minglang-create/Glove_DAQ_project/STM32/G474CBT6/myDoc/frame/SPI事务包格式.png

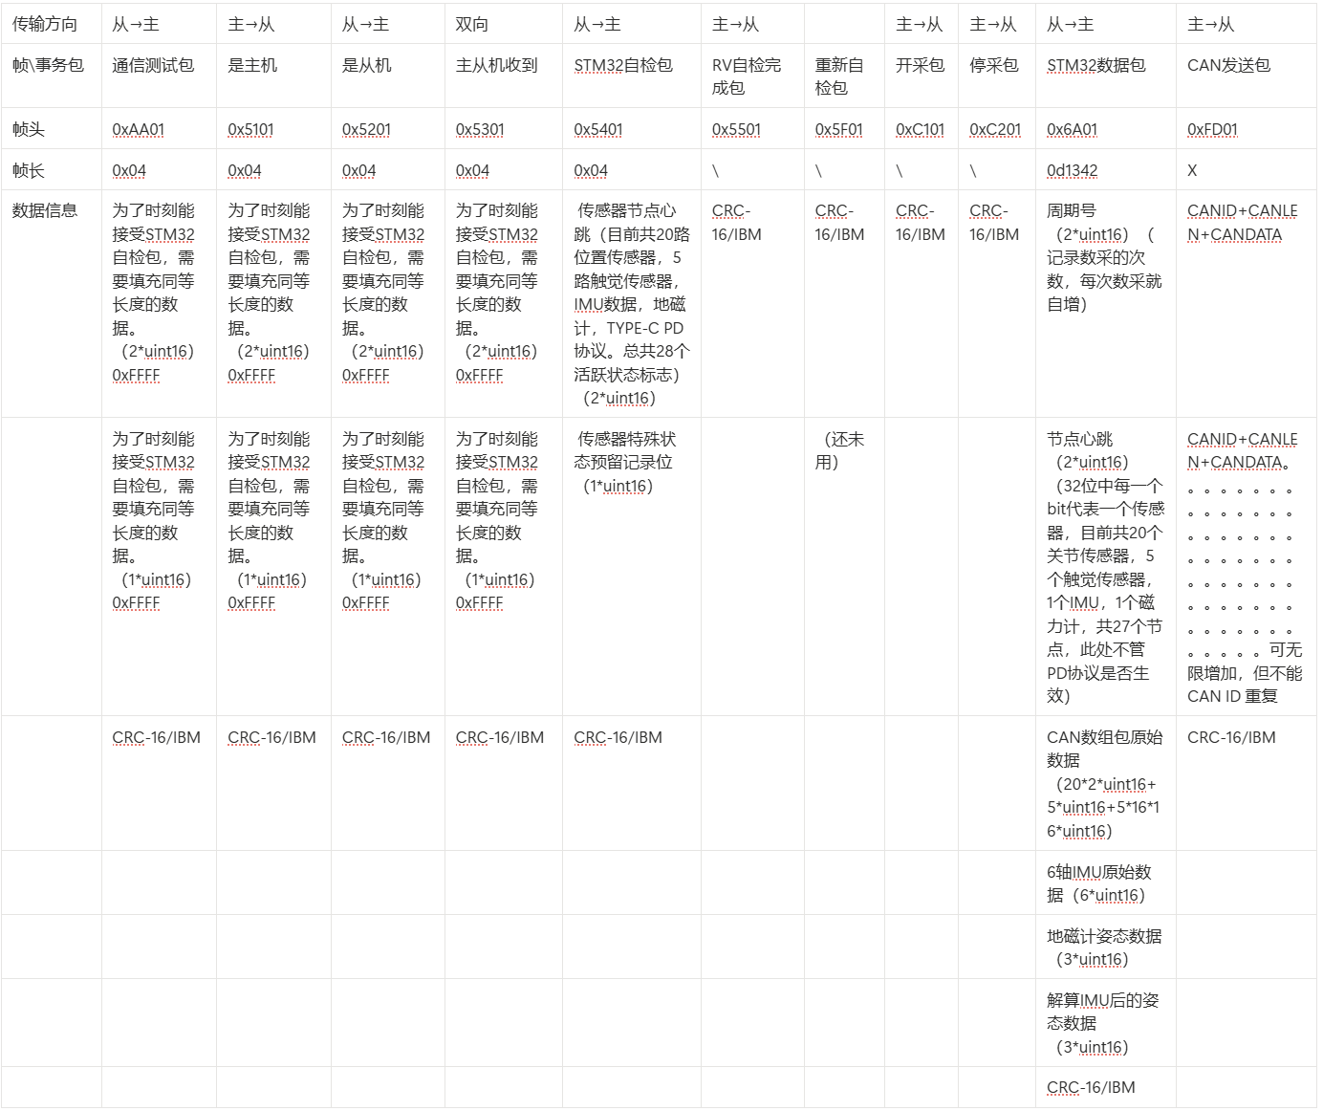
STM32/G474CBT6/myDoc/frame/SPI事务包格式.png
