minglang-create/Glove_DAQ_project/STM32/G474CBT6/myDoc/PCB/BOOT_POWER.png

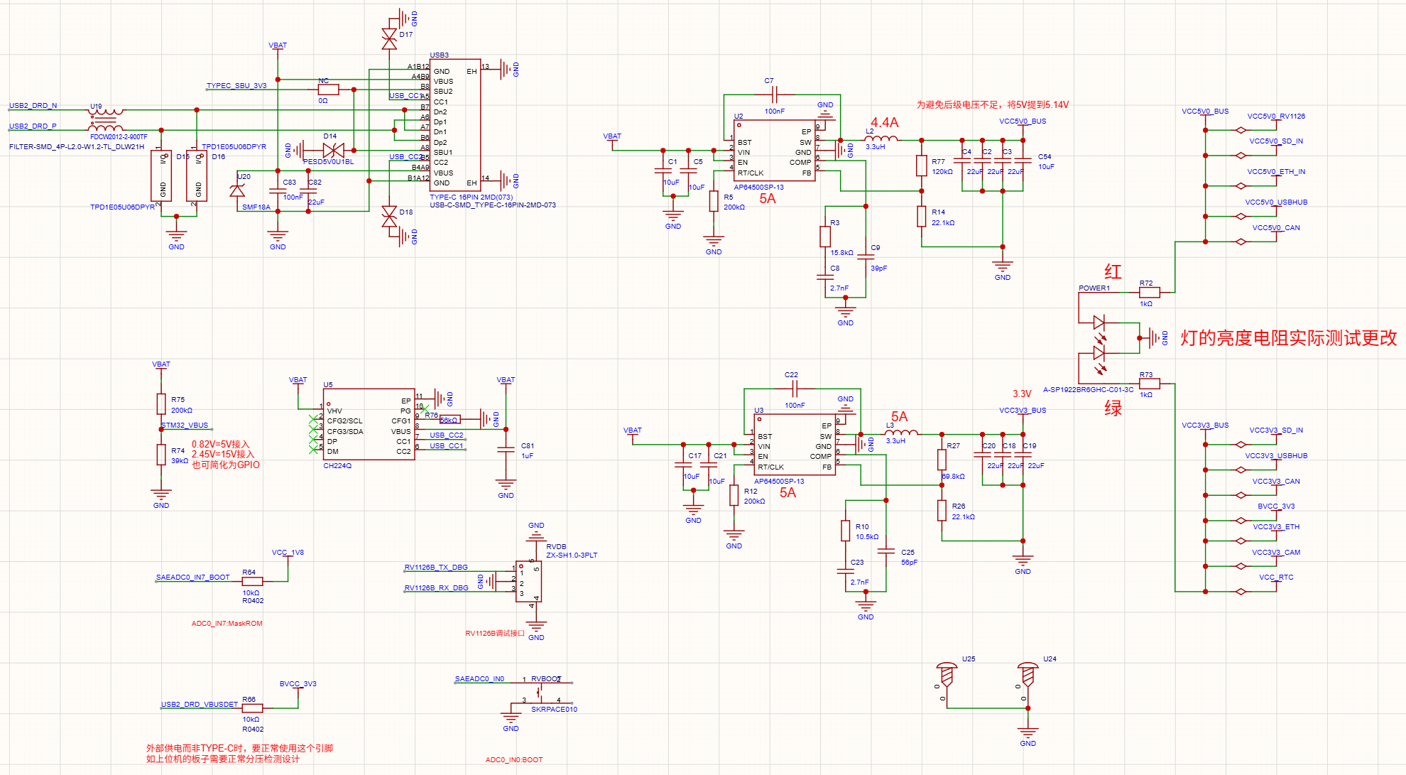
STM32/G474CBT6/myDoc/PCB/BOOT_POWER.png
