minglang-create/Glove_DAQ_project/STM32/G474CBT6/myDoc/PCB/ETH.png

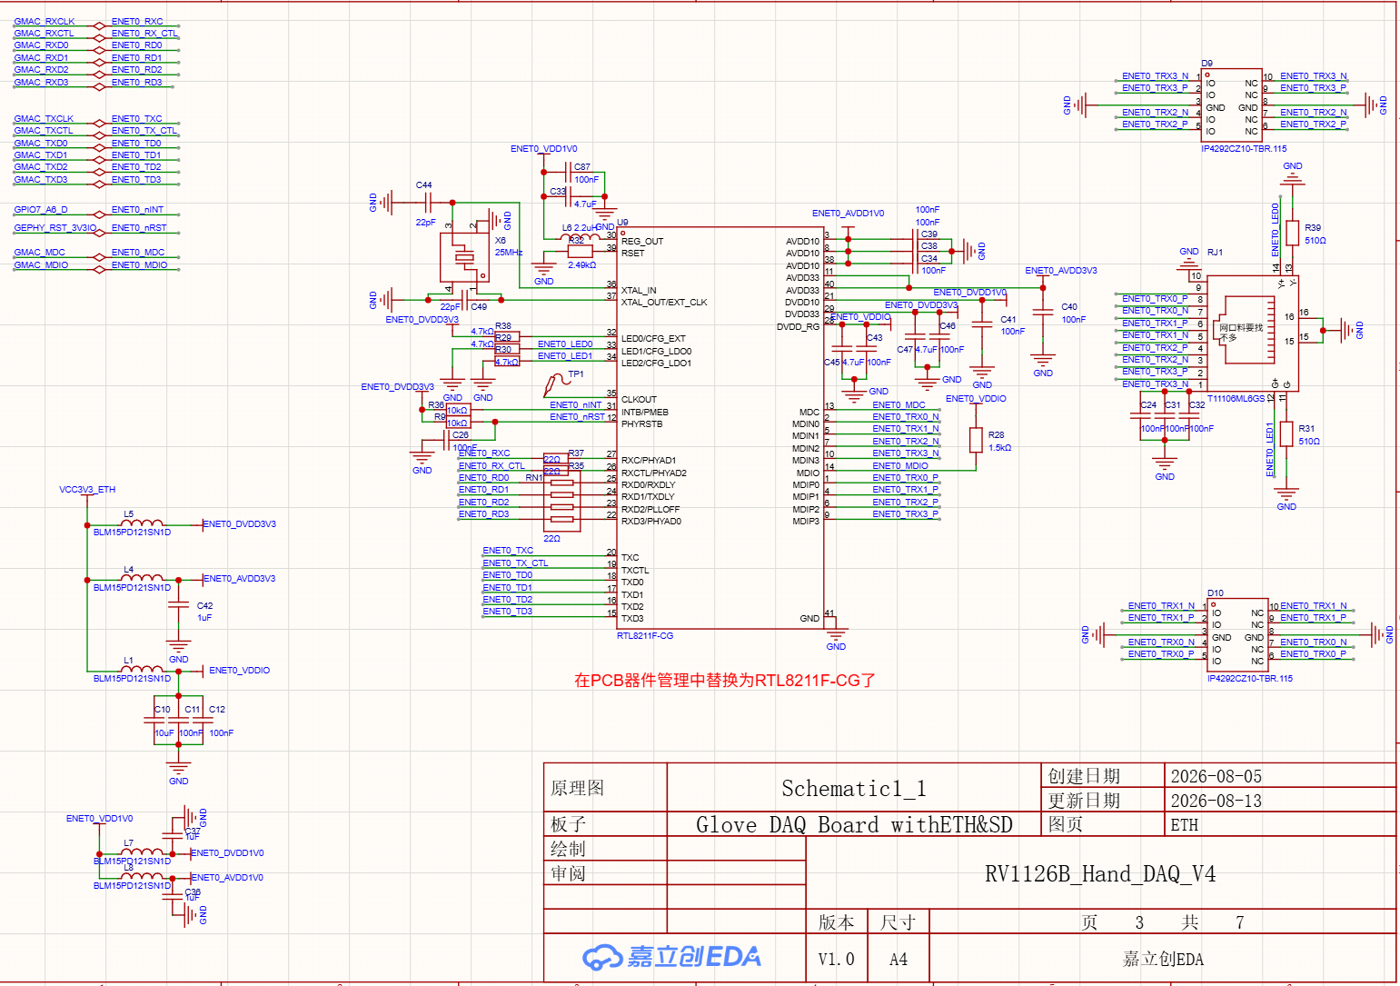
STM32/G474CBT6/myDoc/PCB/ETH.png
