minglang-create/Glove_DAQ_project/STM32/G474CBT6/myDoc/PCB/INTERFACE.png

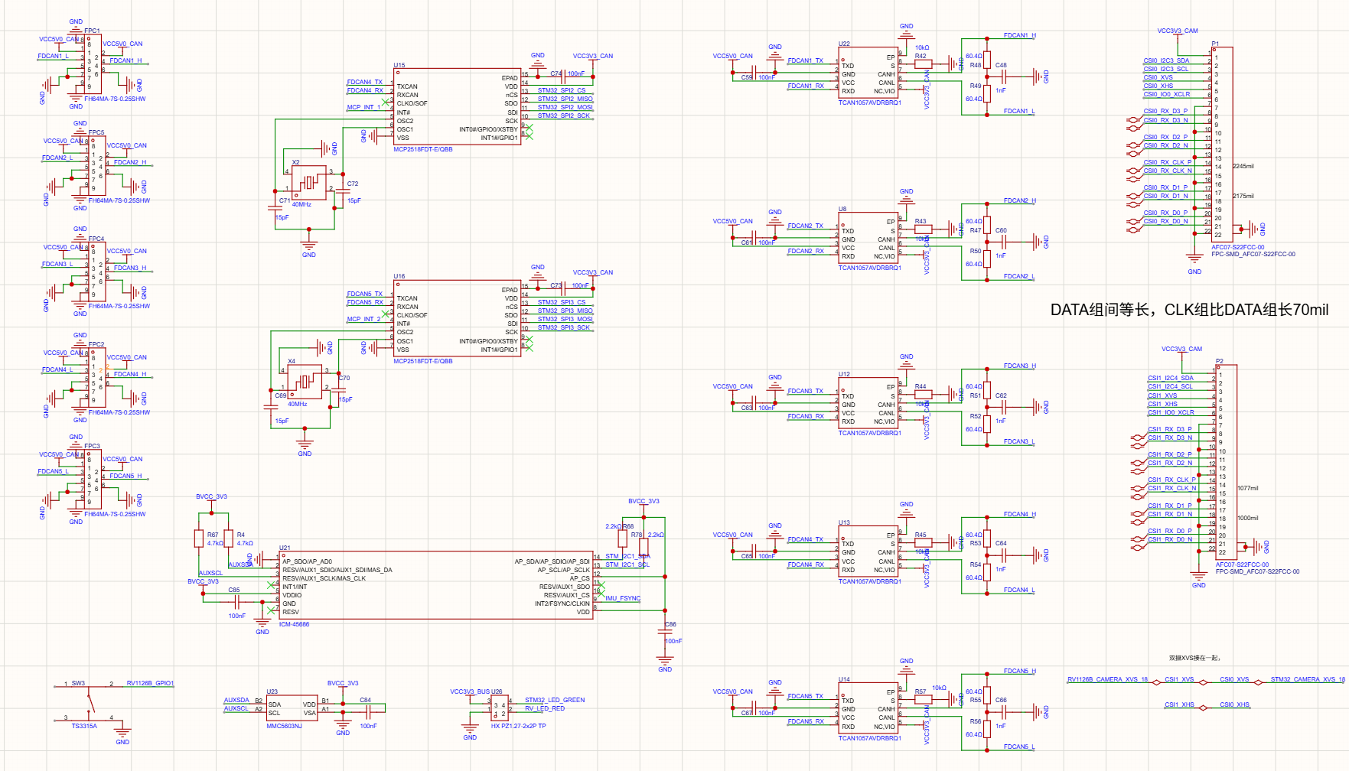
STM32/G474CBT6/myDoc/PCB/INTERFACE.png
