minglang-create/Glove_DAQ_project/STM32/G474CBT6/myDoc/PCB/MCU.png

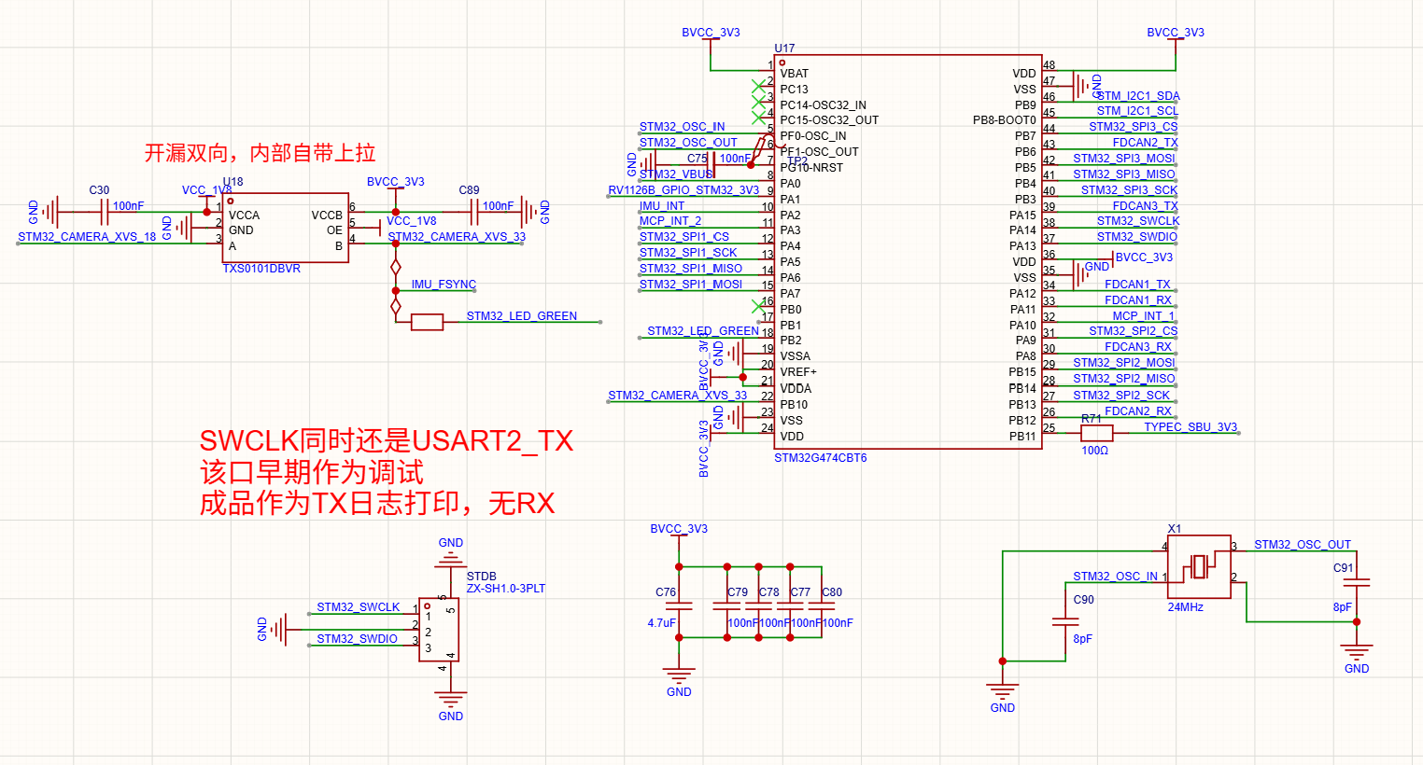
STM32/G474CBT6/myDoc/PCB/MCU.png
