minglang-create/Glove_DAQ_project/STM32/G474CBT6/myDoc/render/bot-5.png

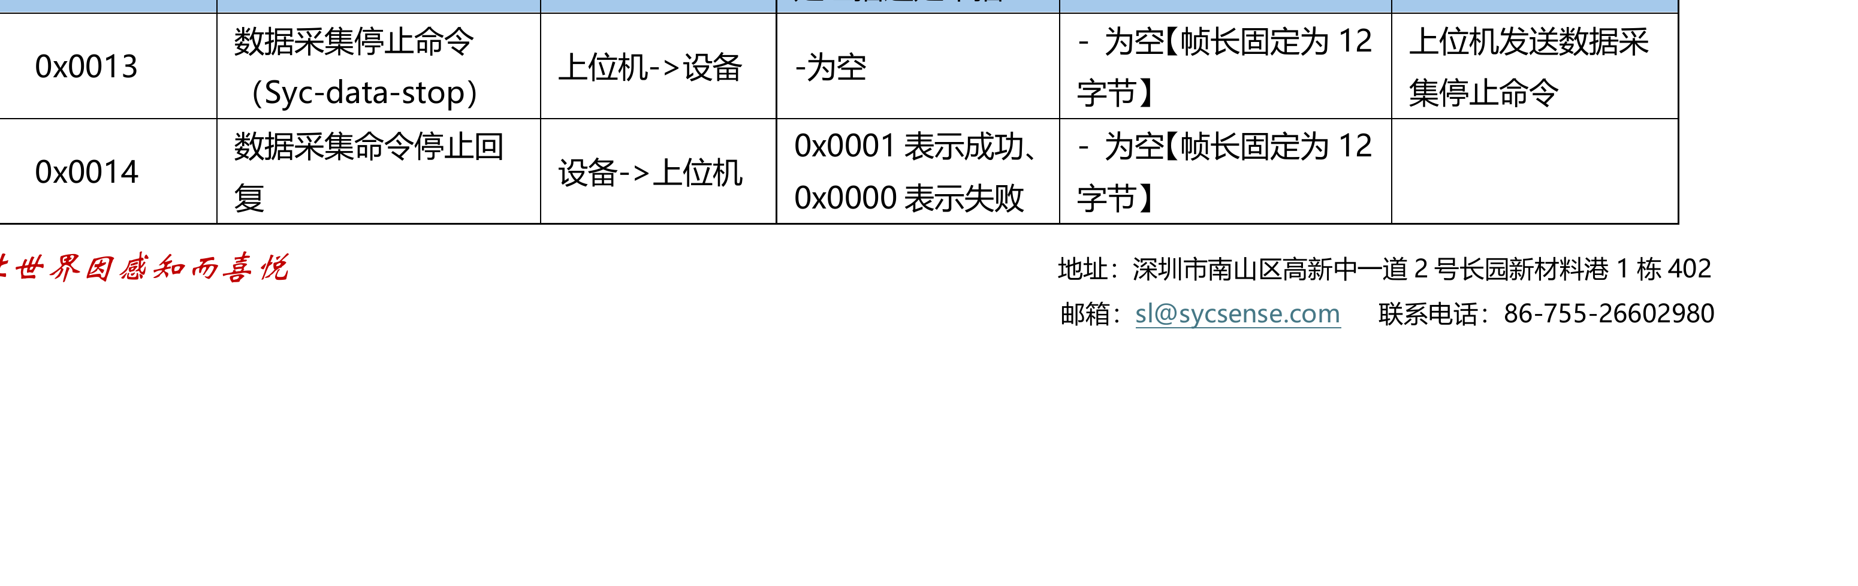
STM32/G474CBT6/myDoc/render/bot-5.png
