minglang-create/Glove_DAQ_project/STM32/G474CBT6/myDoc/render/cell12-5.png

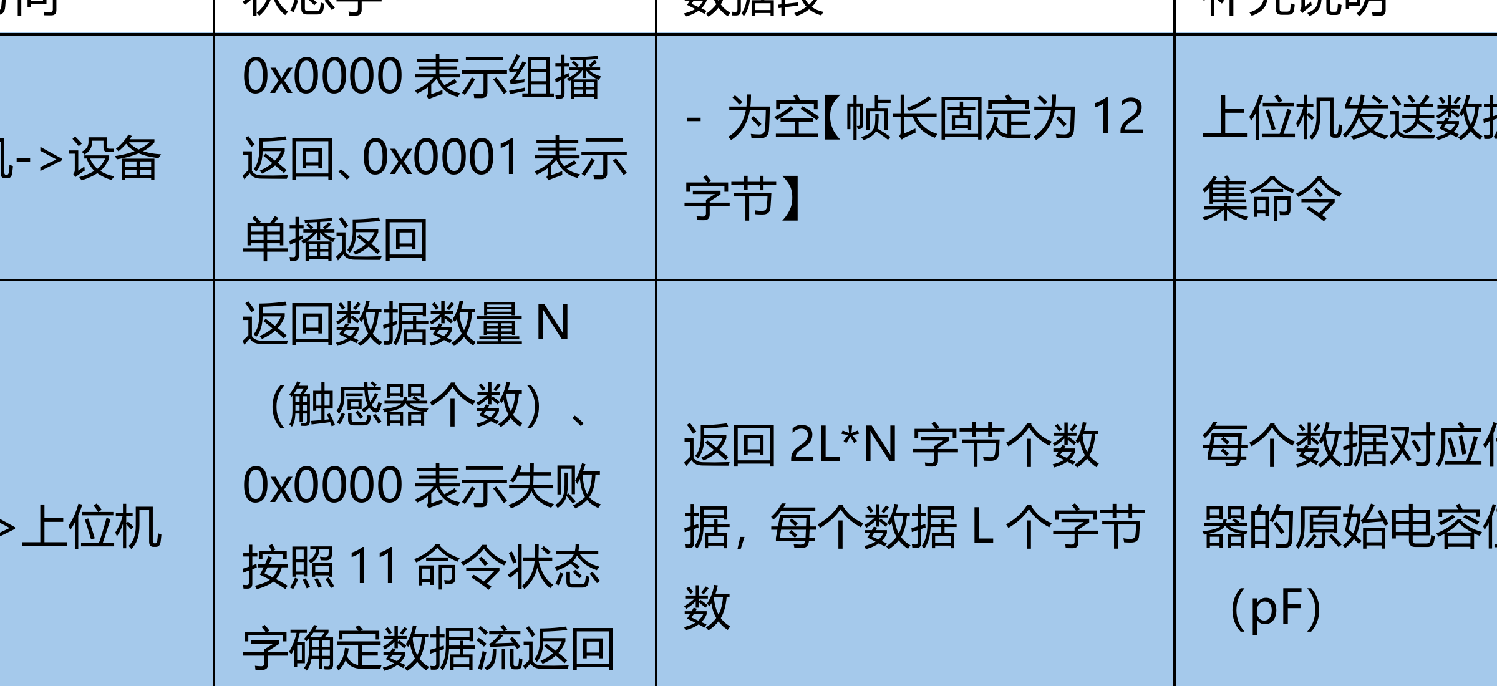
STM32/G474CBT6/myDoc/render/cell12-5.png
