minglang-create/Glove_DAQ_project/STM32/G474CBT6/myDoc/render/p-2.png

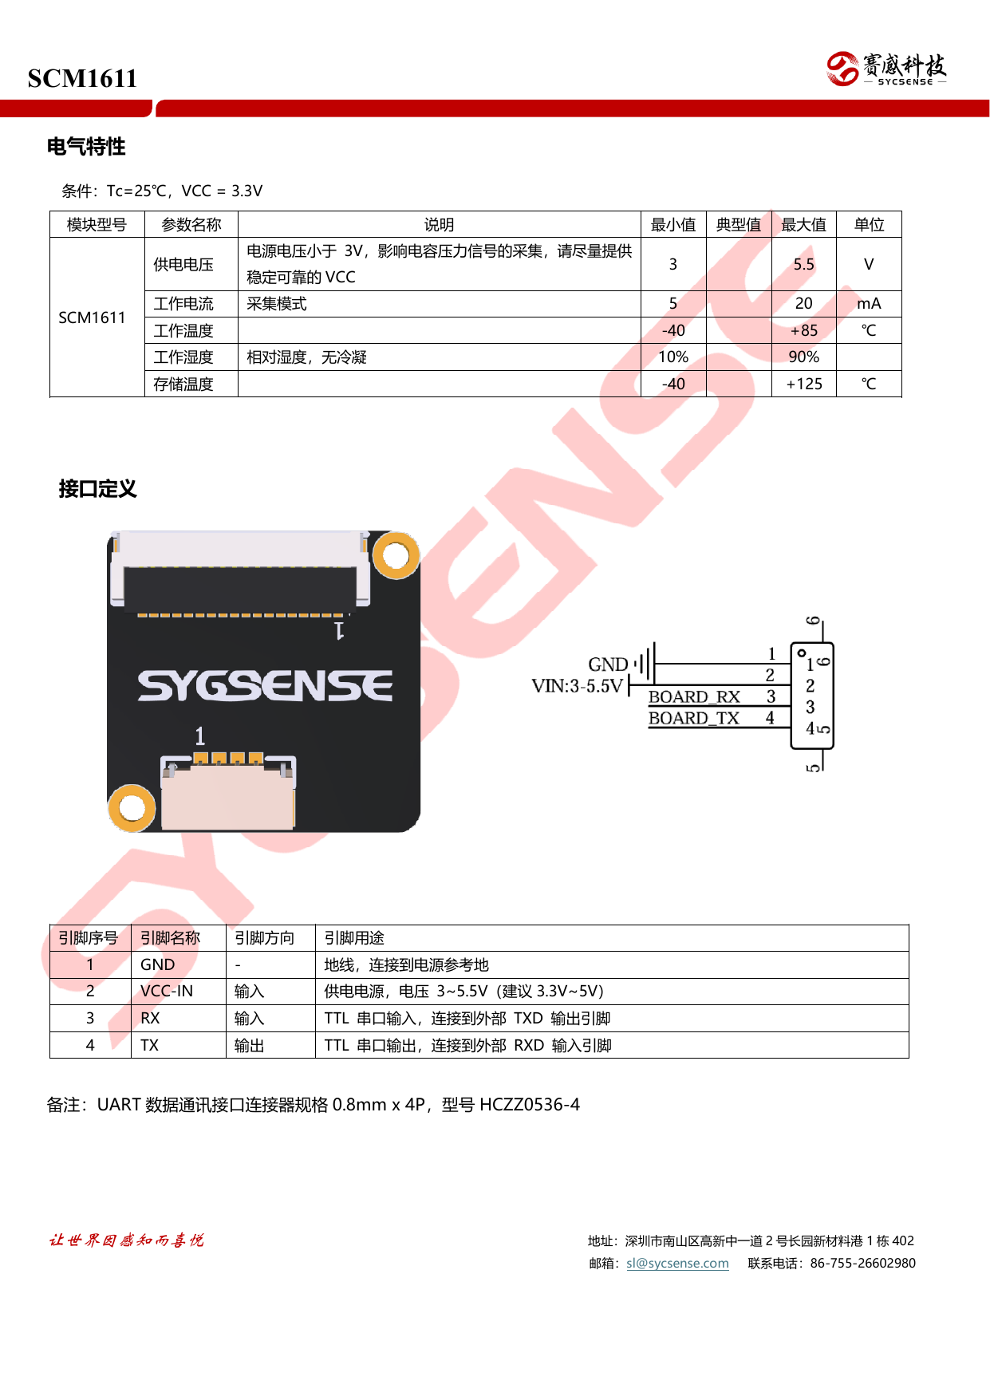
STM32/G474CBT6/myDoc/render/p-2.png
