minglang-create/Glove_DAQ_project/STM32/G474CBT6/myDoc/render/pwm-09.png

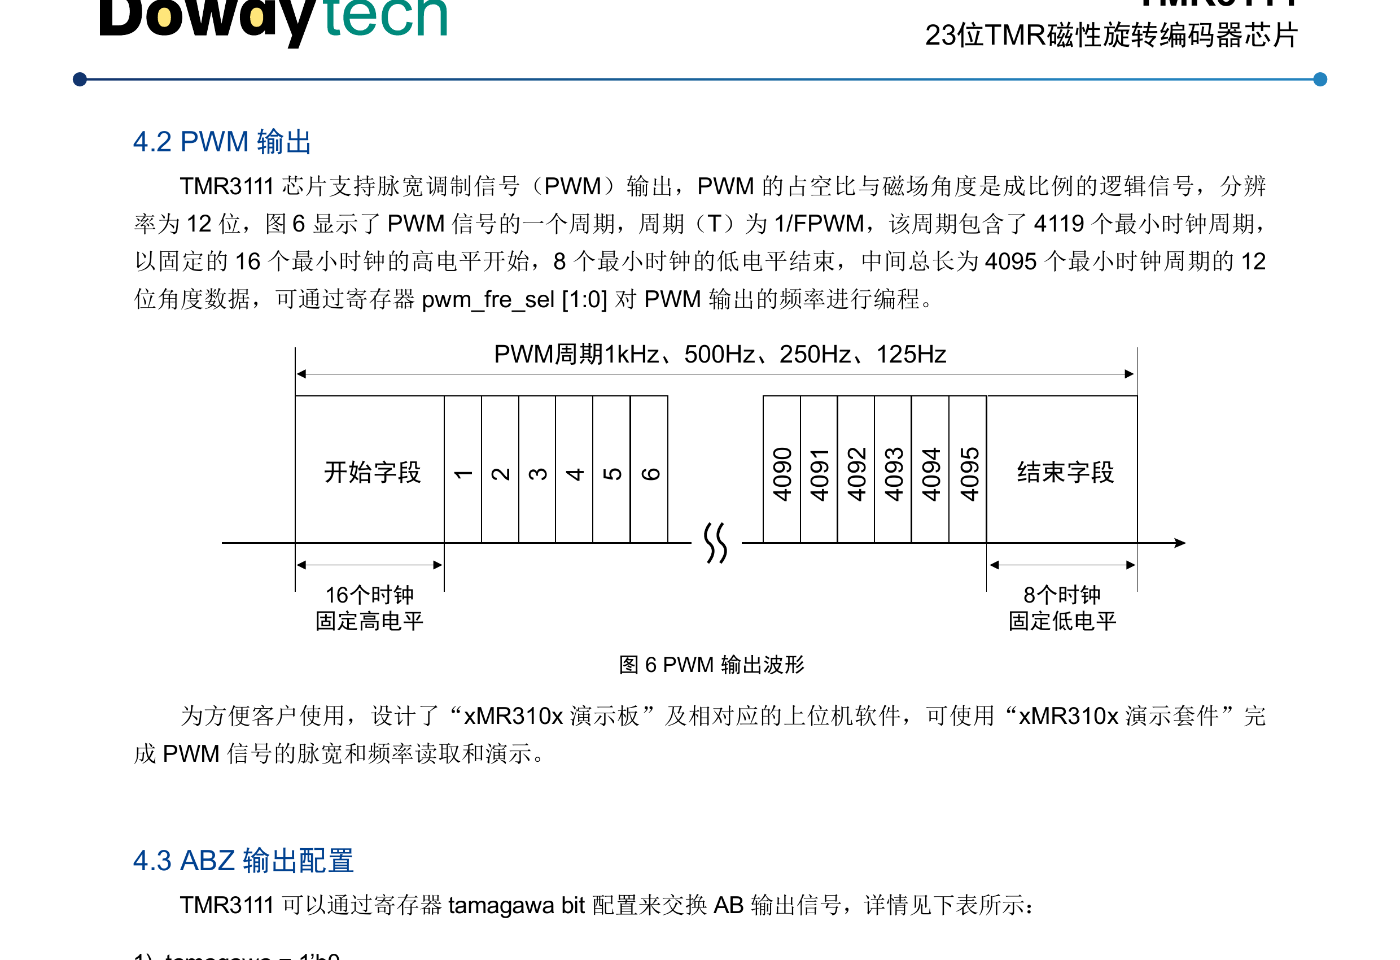
STM32/G474CBT6/myDoc/render/pwm-09.png
