minglang-create/Glove_DAQ_project/STM32/G474CBT6/myDoc/render/tmr-05.png

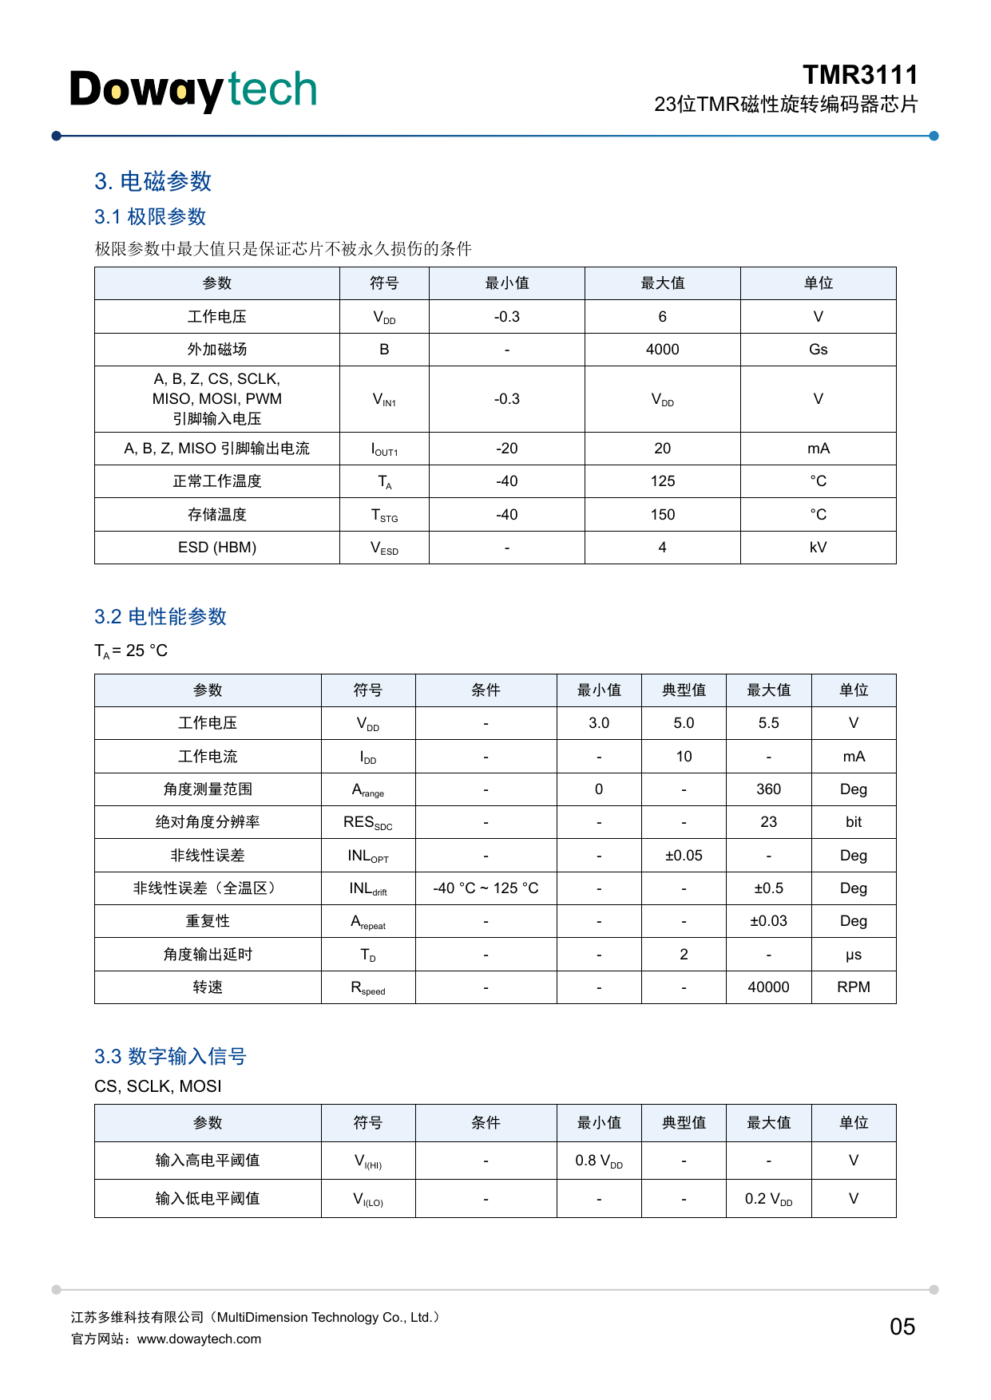
STM32/G474CBT6/myDoc/render/tmr-05.png
