minglang-create/Glove_DAQ_project/STM32/G474CBT6/myDoc/MYZR-RV1126B-LB221-REVA-OPEN.pdf

5

4

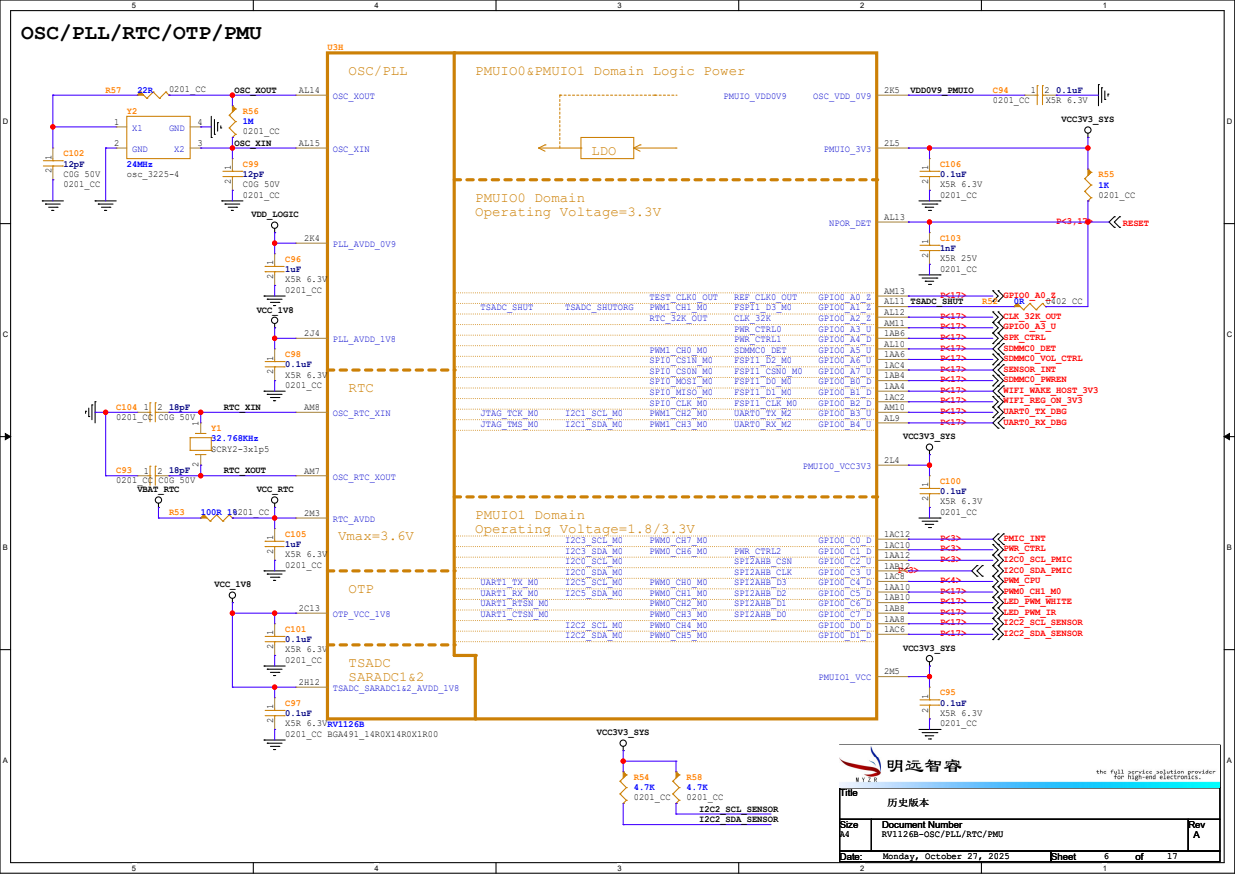
[picture p39: page 1]

OSC/PLL/RTC/OTP/PMU

# DDR Controller

# LPDDR4/4x AC

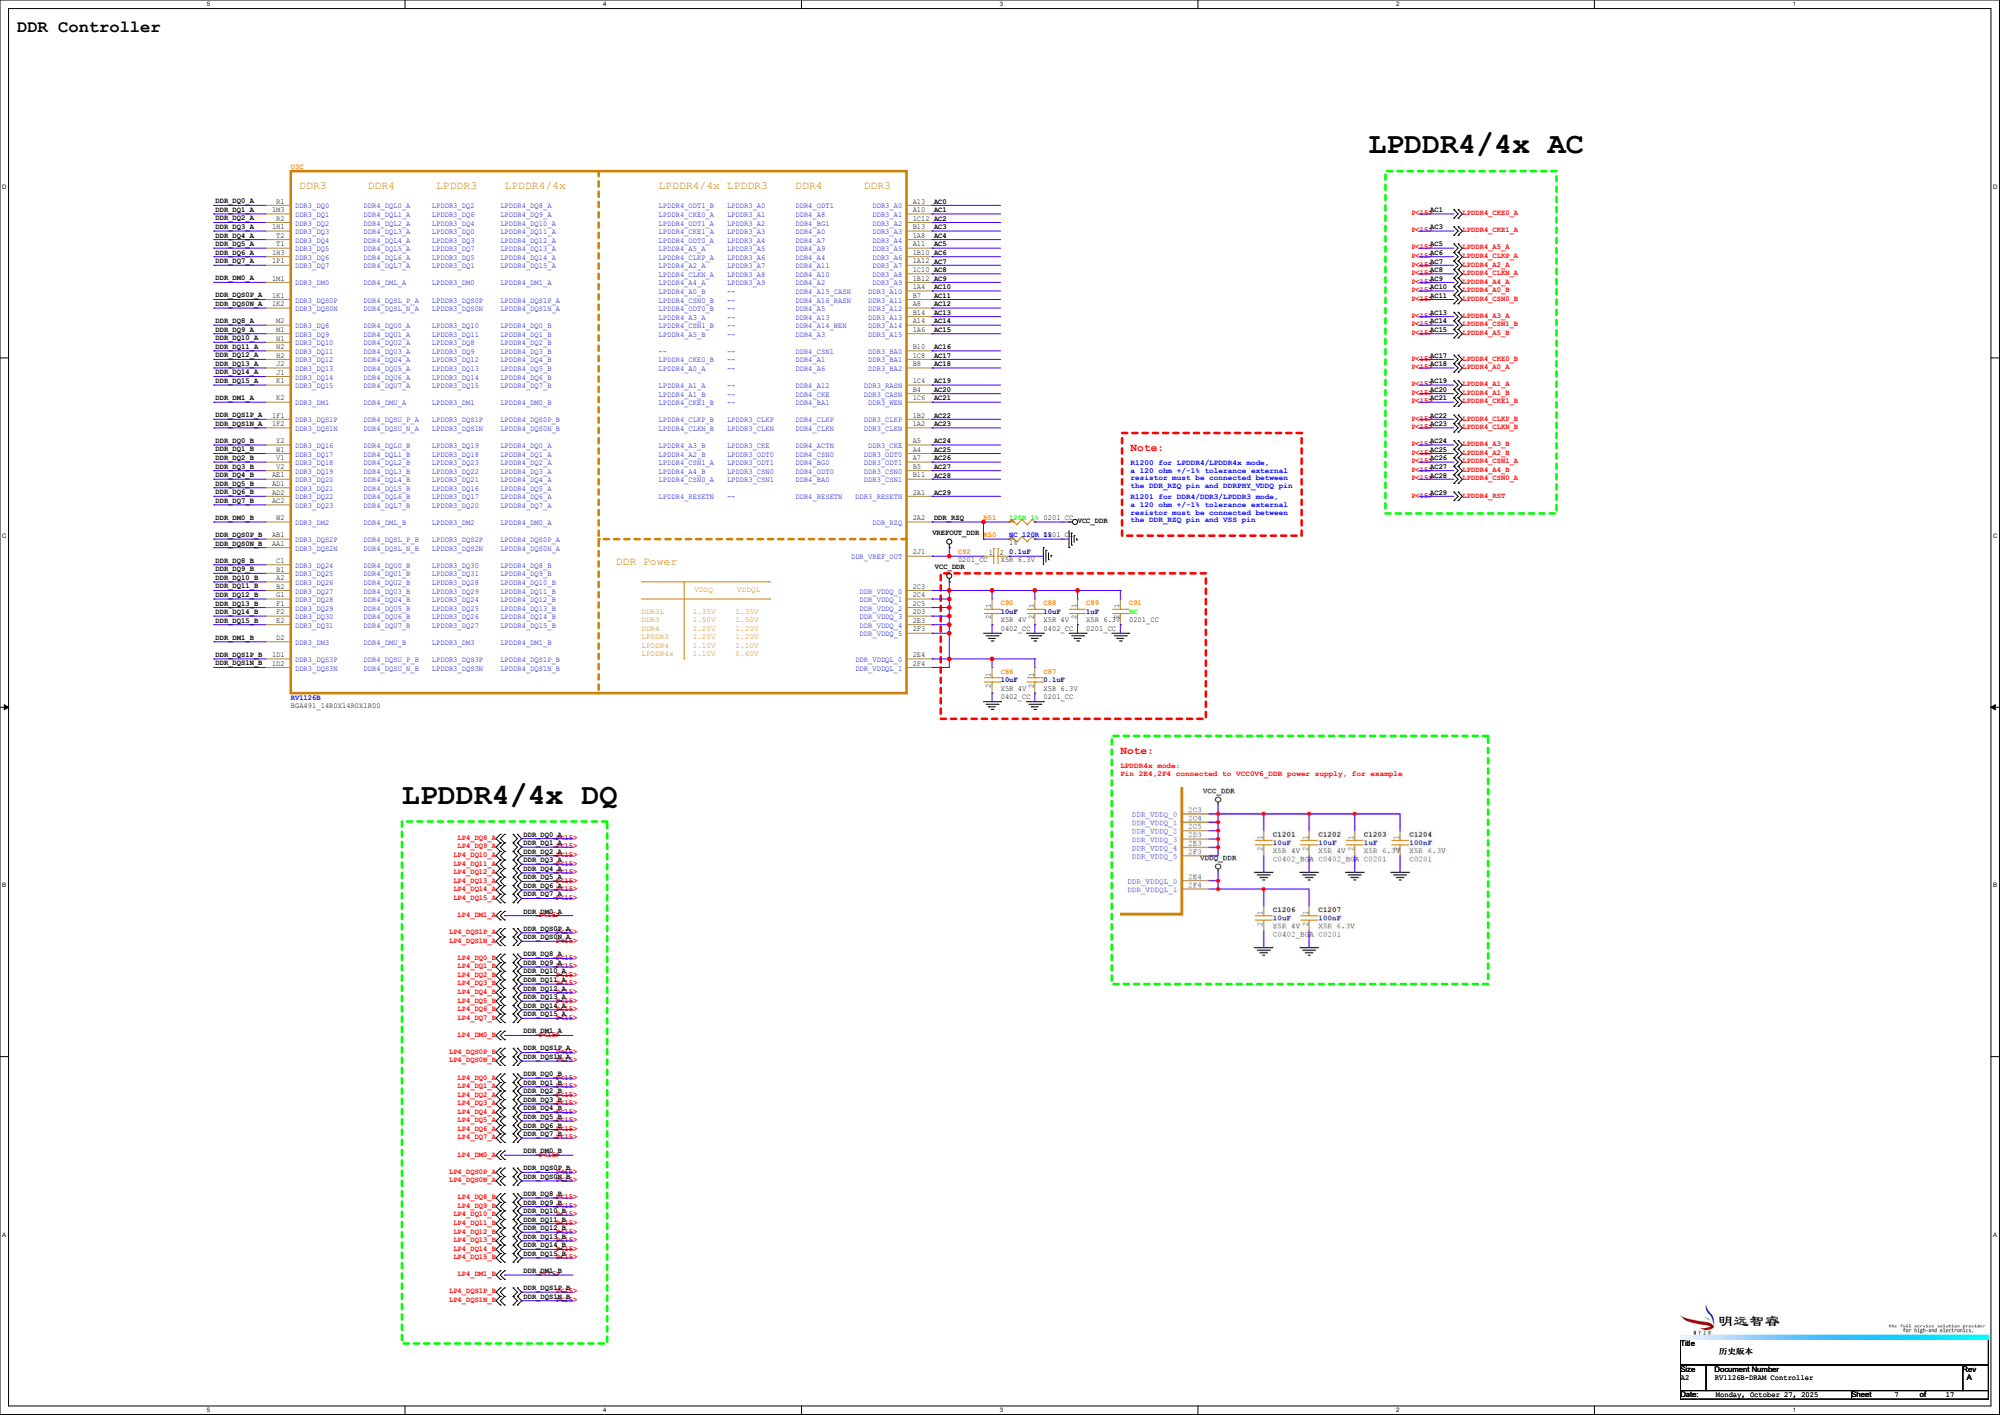
[picture p40: page 2]

R1200 for LPDDR4/LPDDR4x mode,
a 120 ohm +/-1% tolerance external
resistor must be connected between
the DDR_RZQ pin and DDRPHY_VDDQ pin
R1201 for DDR4/DDR3/LPDDR3 mode,
the DDR_RZQ pin and VSS pin

LPDDR4x mode:
Pin 2E4,2F4 connected to VCC0V6_DDR power supply, for example

# EMMC/FSPI

## VCCIO1 Domain

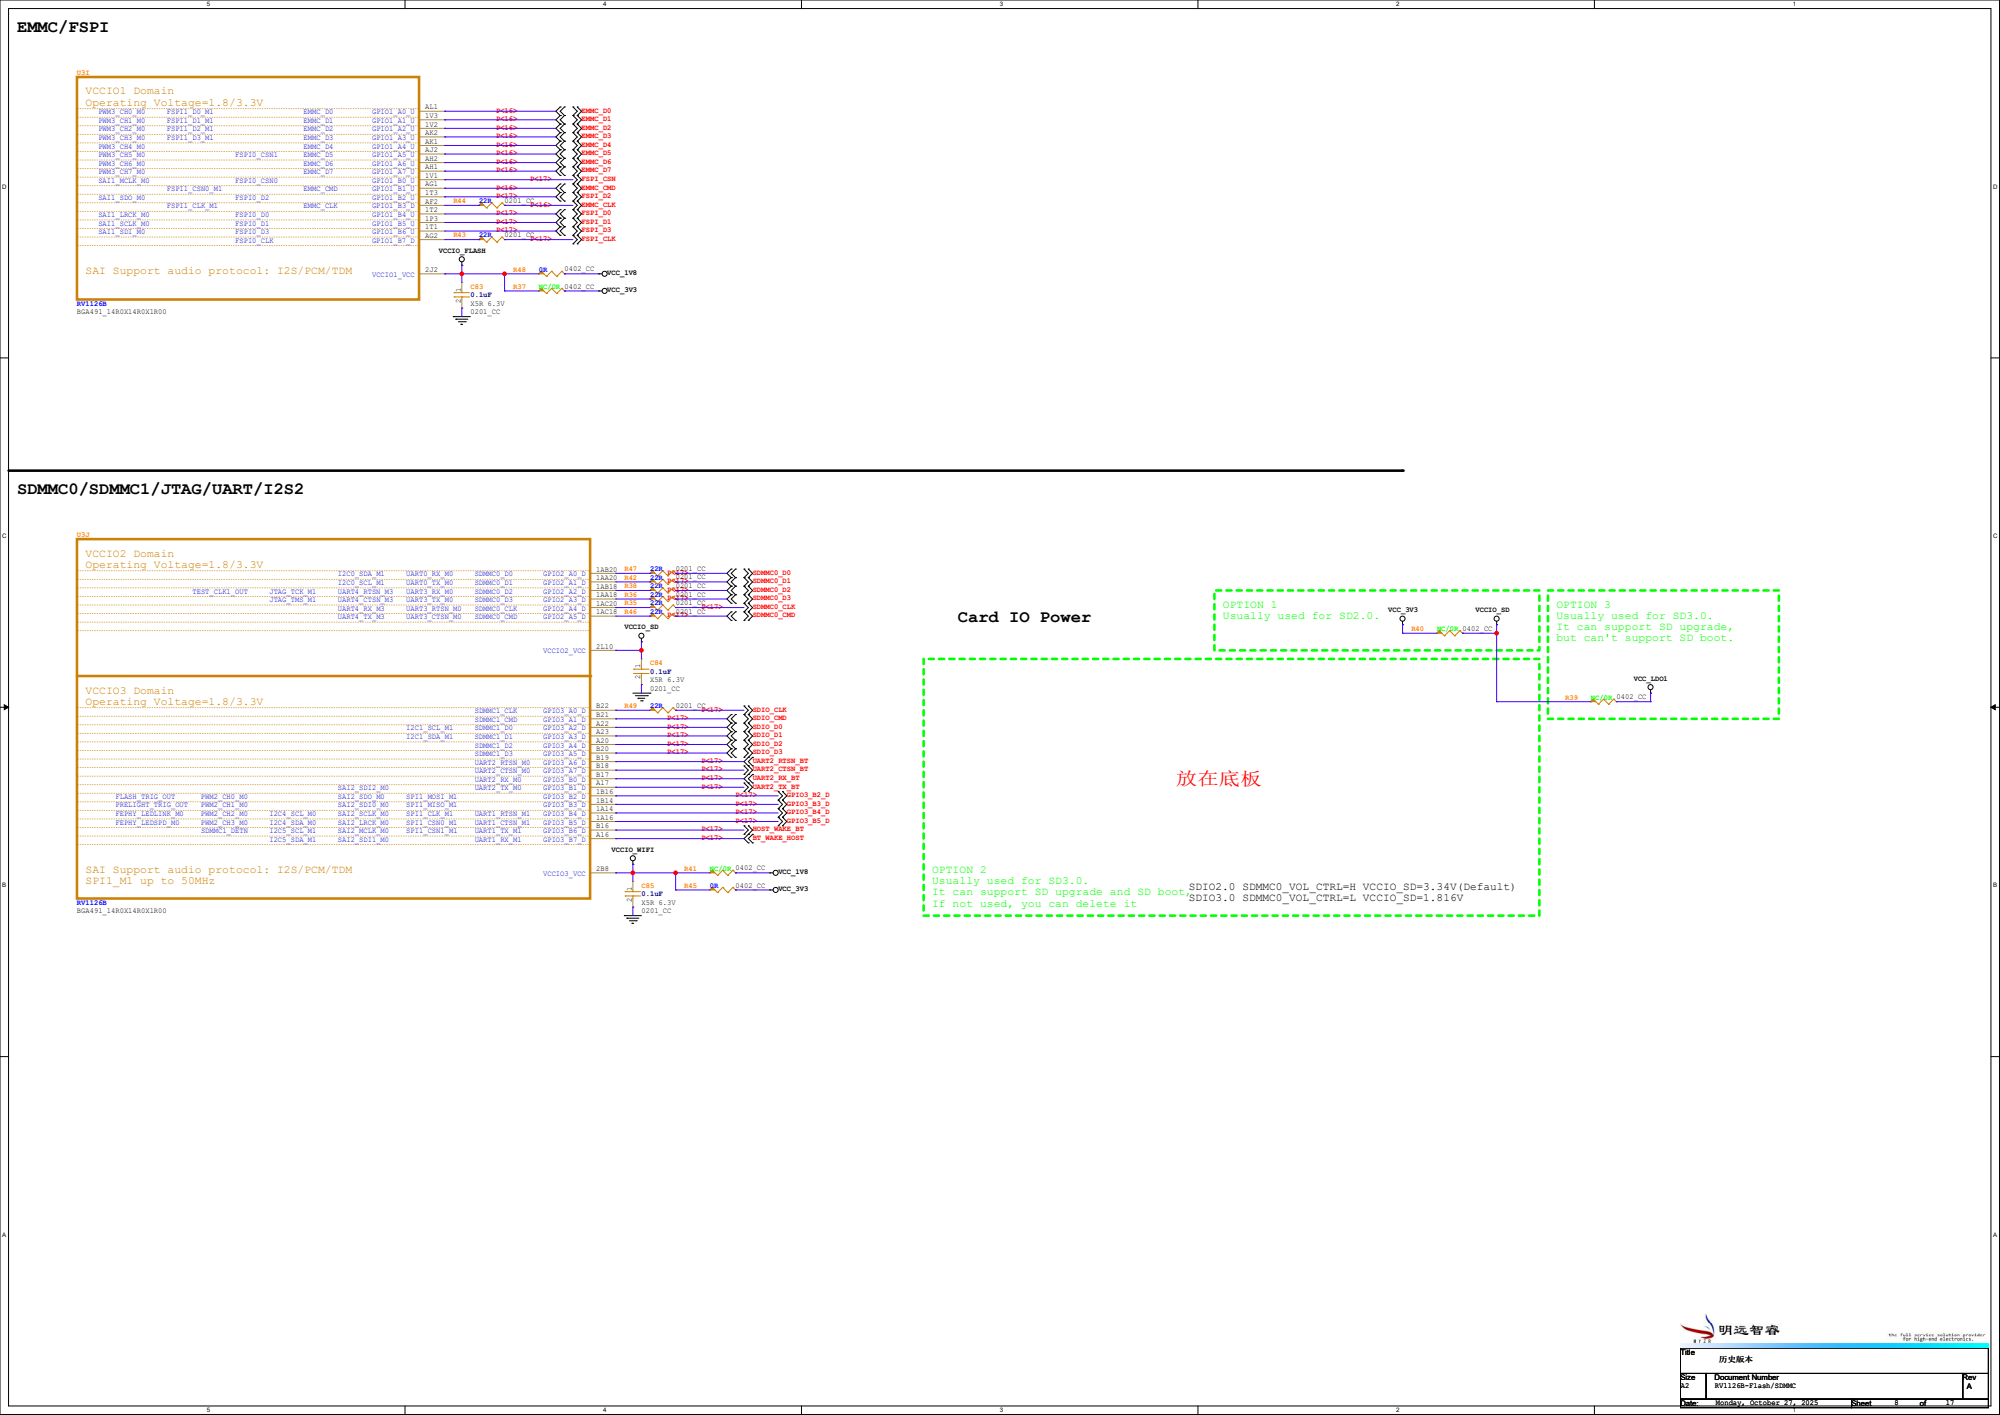
[picture p41: page 3]

SAI Support audio protocol: I2S/PCM/TDM

Usually used for SD3.0.
It can support SD upgrade,
but can't support SD boot.

SPI1_M1 up to 50MHz

OPTION 2
It can support SD upgrade and SD boot,
If not used, you can delete it

D D

# USB Controller

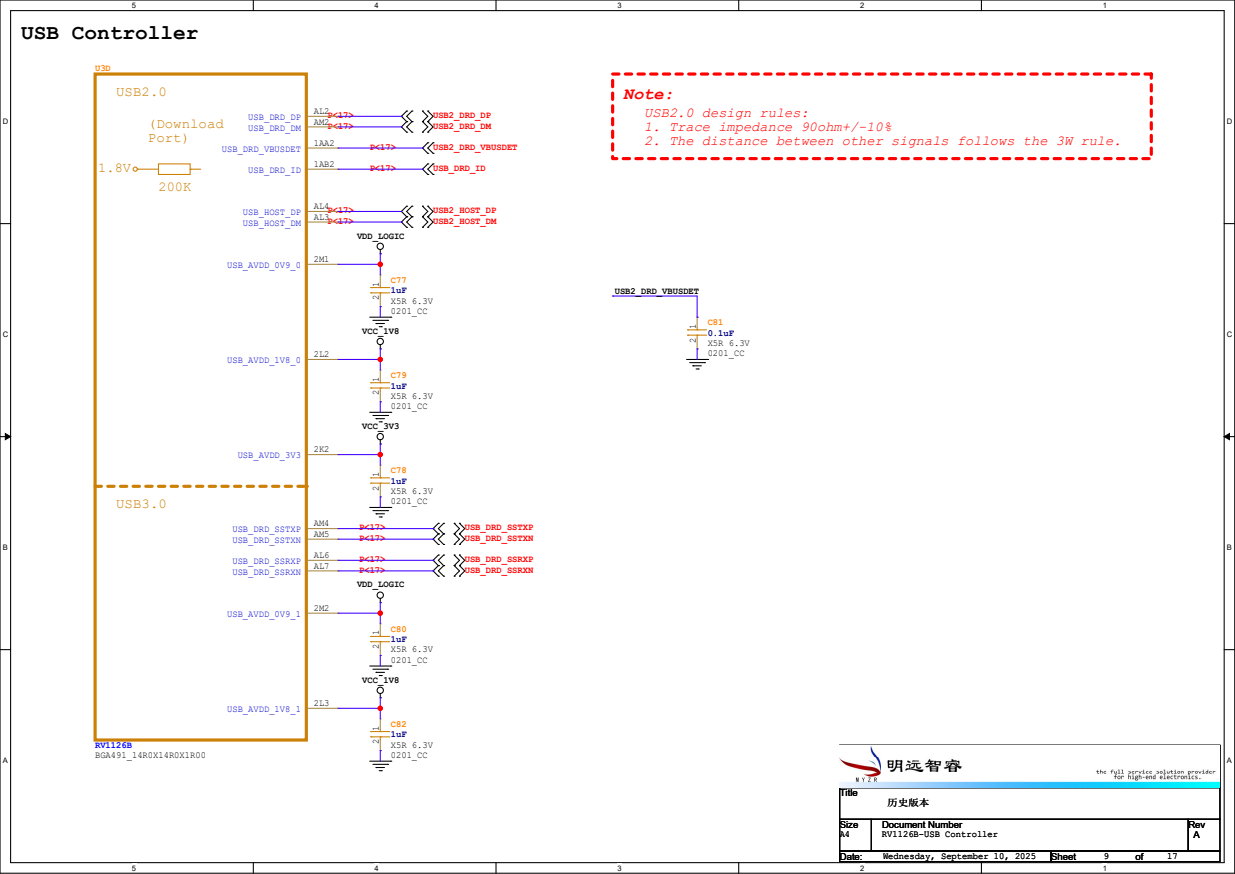
[picture p42: page 4]
VDD_LOGIC; VCC_1V8; VCC_3V3; USB2_DRD_DP; USB2_DRD_DM; USB2_DRD_VBUSDET; USB2_HOST_DP; USB2_HOST_DM; USB_DRD_SSTXP; USB_DRD_SSTXN; USB_DRD_SSRXP; USB_DRD_SSRXN; USB_DRD_ID; Title; RV1126B-USB Controller; Wednesday, September 10, 2025; USB3.0; USB2.0; (Download Port); RV1126B BGA491_14R0X14R0X1R00; USB_DRD_VBUSDET 1AA2; USB_AVDD_1V8_0 2L2; USB_AVDD_3V3 2K2; USB_HOST_DM AL3 USB_HOST_DP AL4; USB_DRD_DM AM2 USB_DRD_DP AL2; USB_DRD_ID 1AB2; USB_AVDD_0V9_0 2M1; USB_AVDD_0V9_1 2M2; USB_AVDD_1V8_1 2L3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

Note:
USB2.0 design rules:
1. Trace impedance 90ohm+/-10%
2. The distance between other signals follows the 3W rule.

D D

# SARADC0

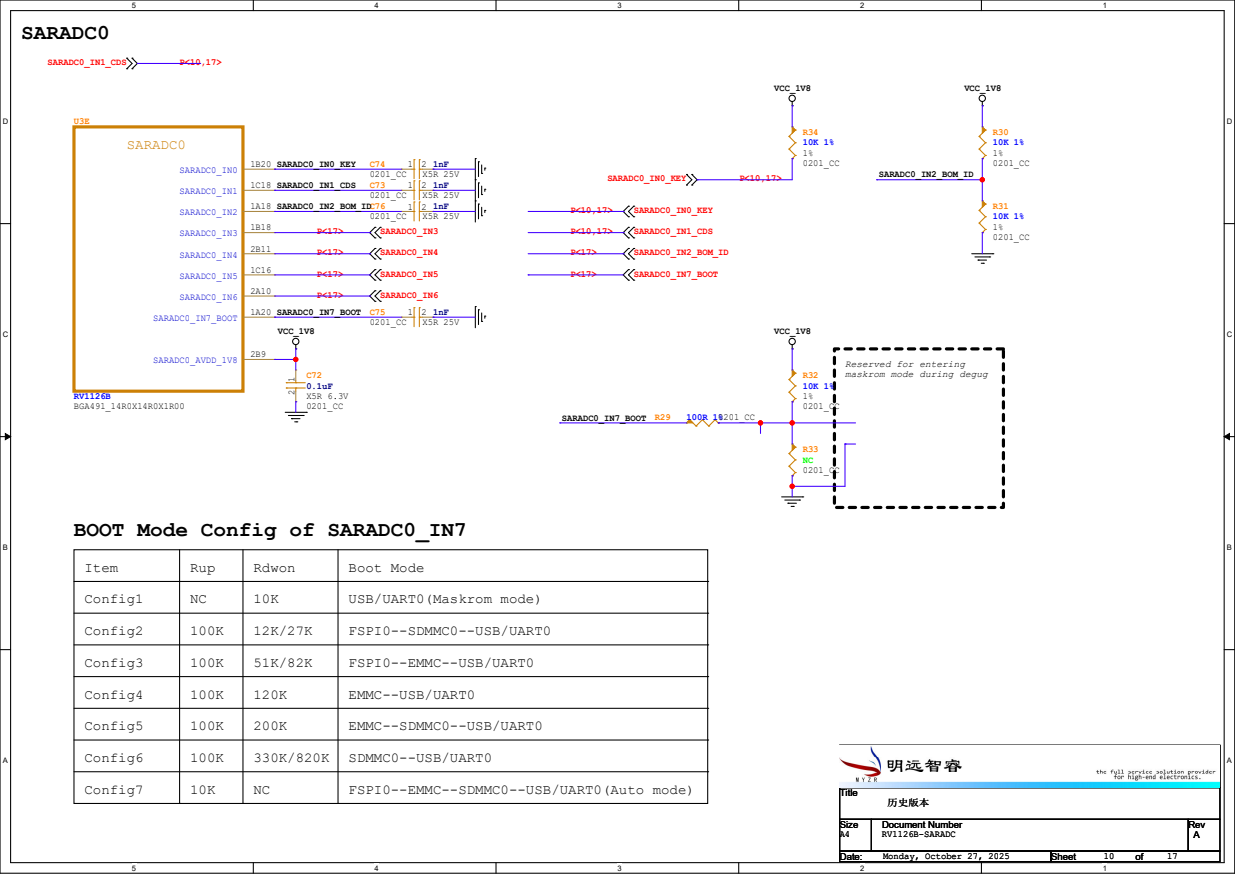
[picture p43: page 5]

Reserved for entering
maskrom mode during degug

BOOT Mode Config of SARADC0_IN7

FSPI0--EMMC--SDMMC0--USB/UART0(Auto mode)

VI_CIF/ETH/SAI/UART/PWM/I2C | MIPI-CSI
P<17> | MIPI_CSI_RX0_D0P

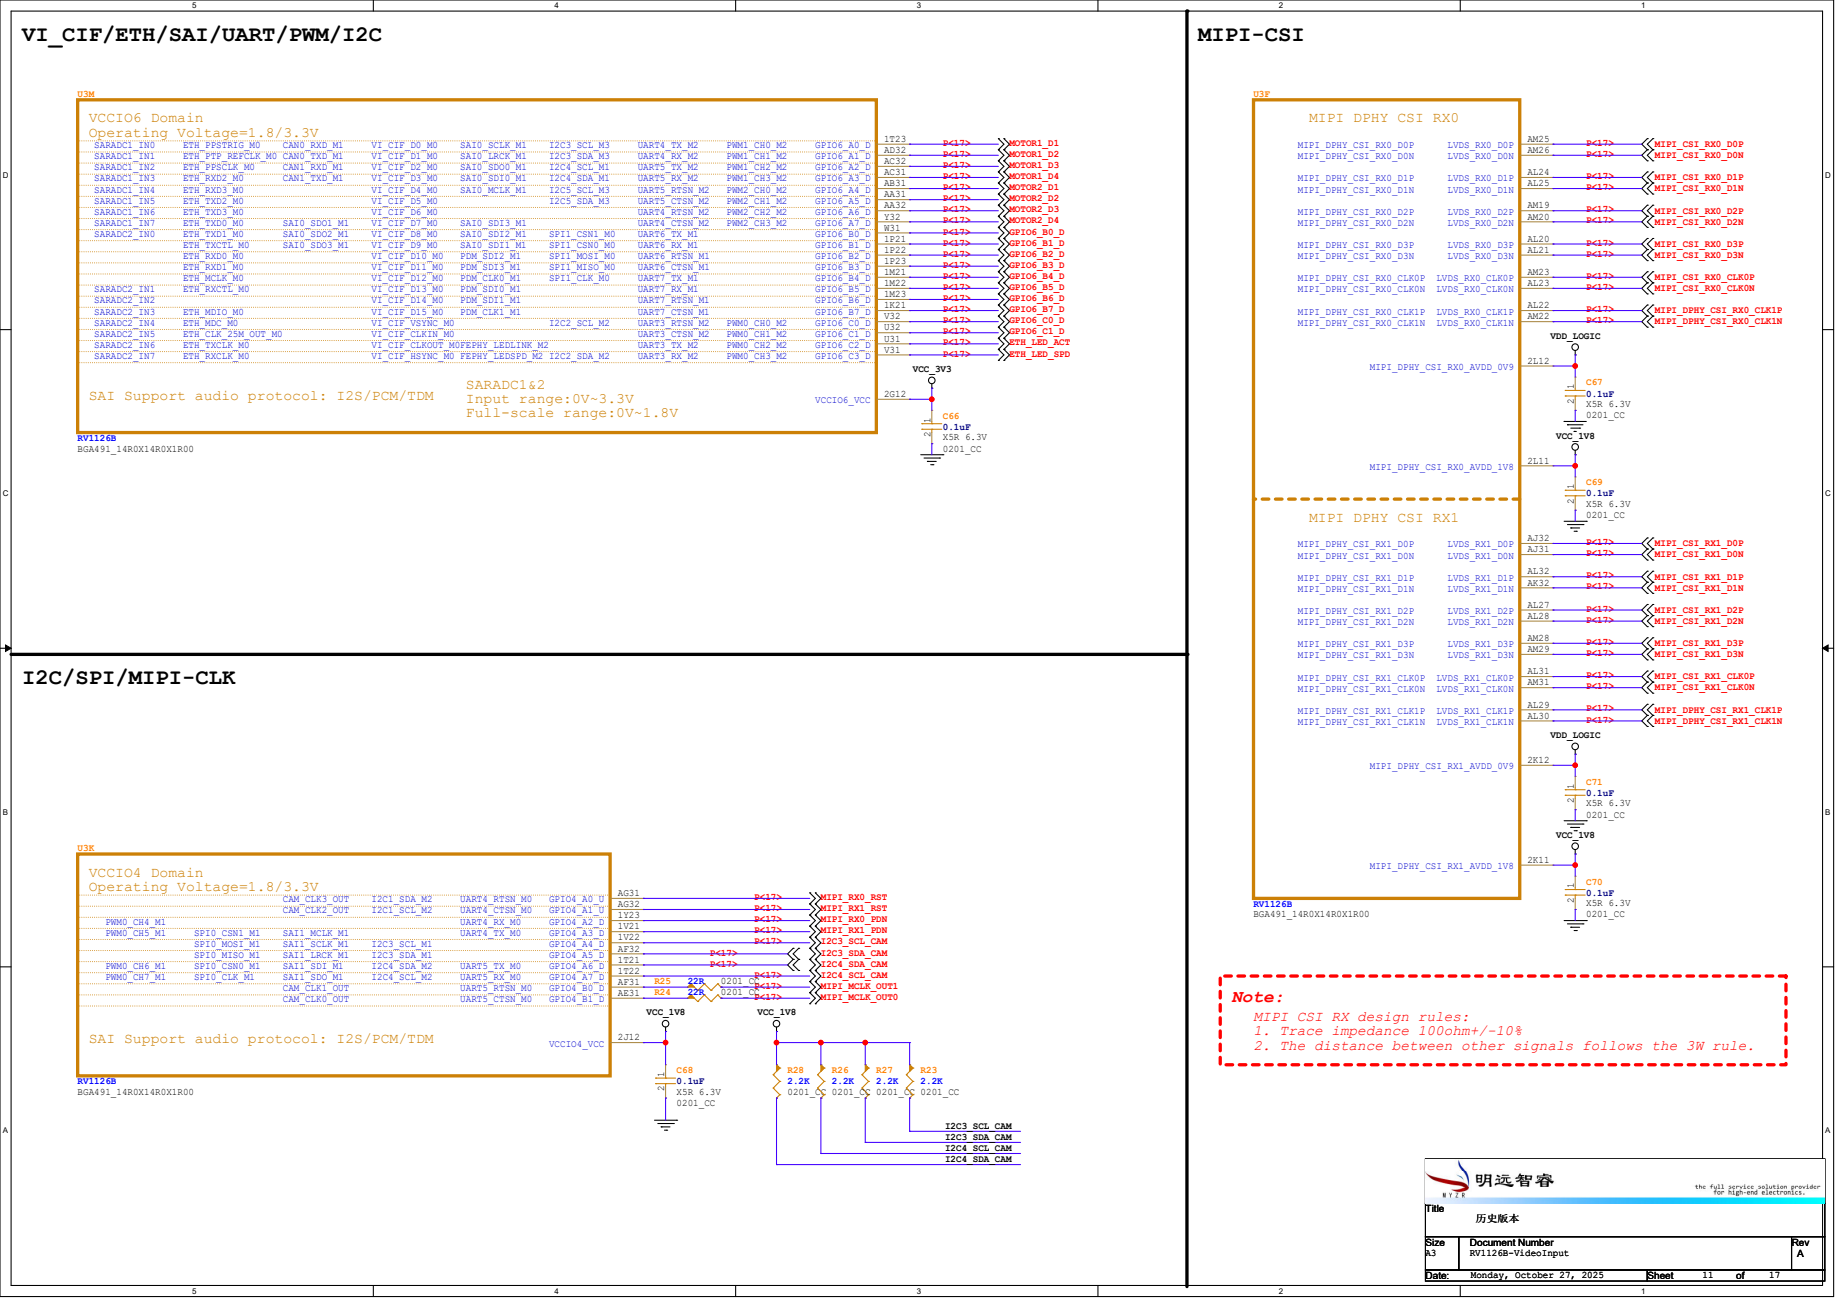
[picture p44: page 6]

MIPI CSI RX design rules:
1. Trace impedance 100ohm+/-10%
2. The distance between other signals follows the 3W rule.

SAI Support audio protocol: I2S/PCM/TDM

# VO_LCDC/VI_CIF/ETH/SAI/UART/PWM/I2C

## P<12,17> I2C5_SCL_TP

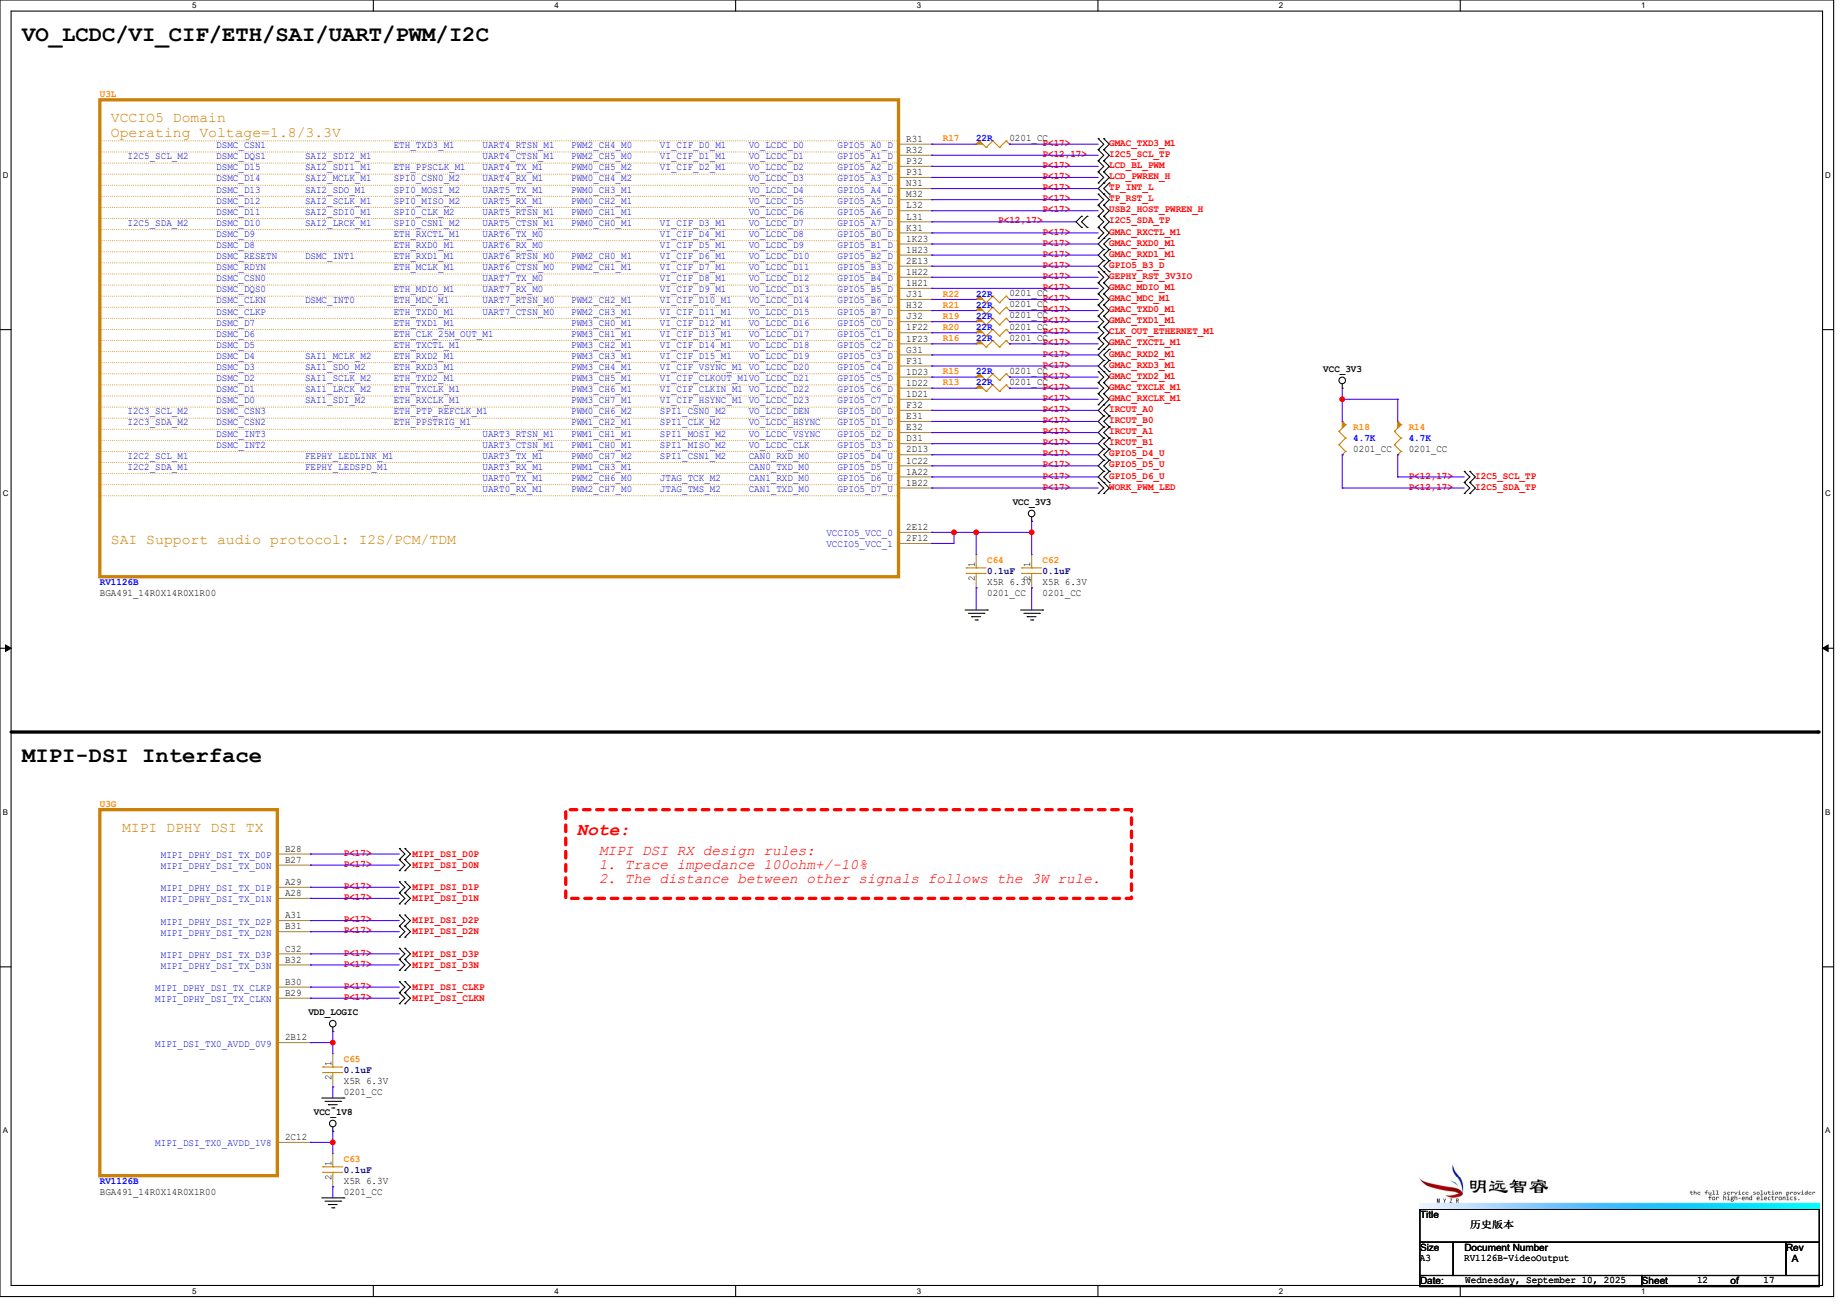
[picture p45: page 7]

SAI Support audio protocol: I2S/PCM/TDM

MIPI DPHY DSI TX

Note:
MIPI DSI RX design rules:
1. Trace impedance 100ohm+/-10%
2. The distance between other signals follows the 3W rule.

D D

# Audio Interface

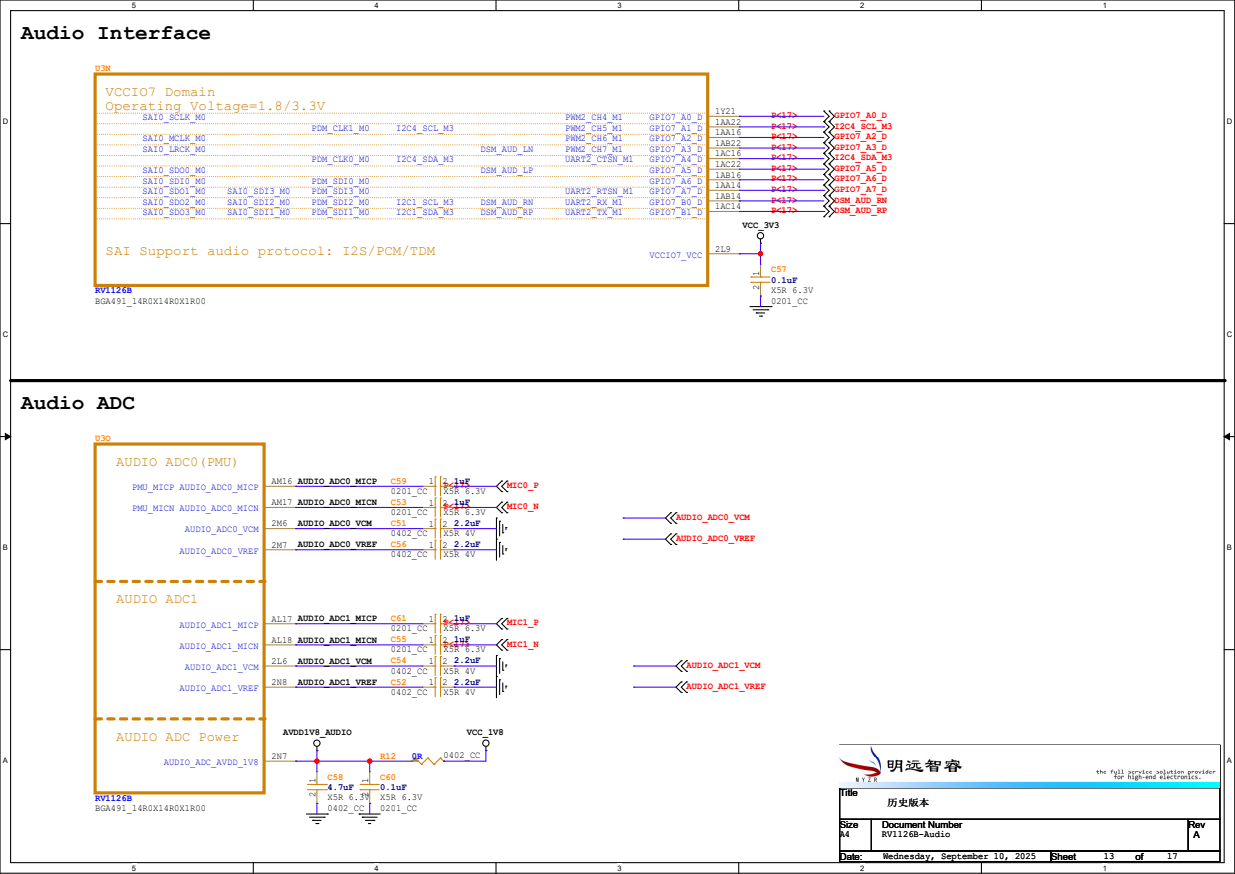
[picture p46: page 8]

SAI Support audio protocol: I2S/PCM/TDM

D D

# FEPHY

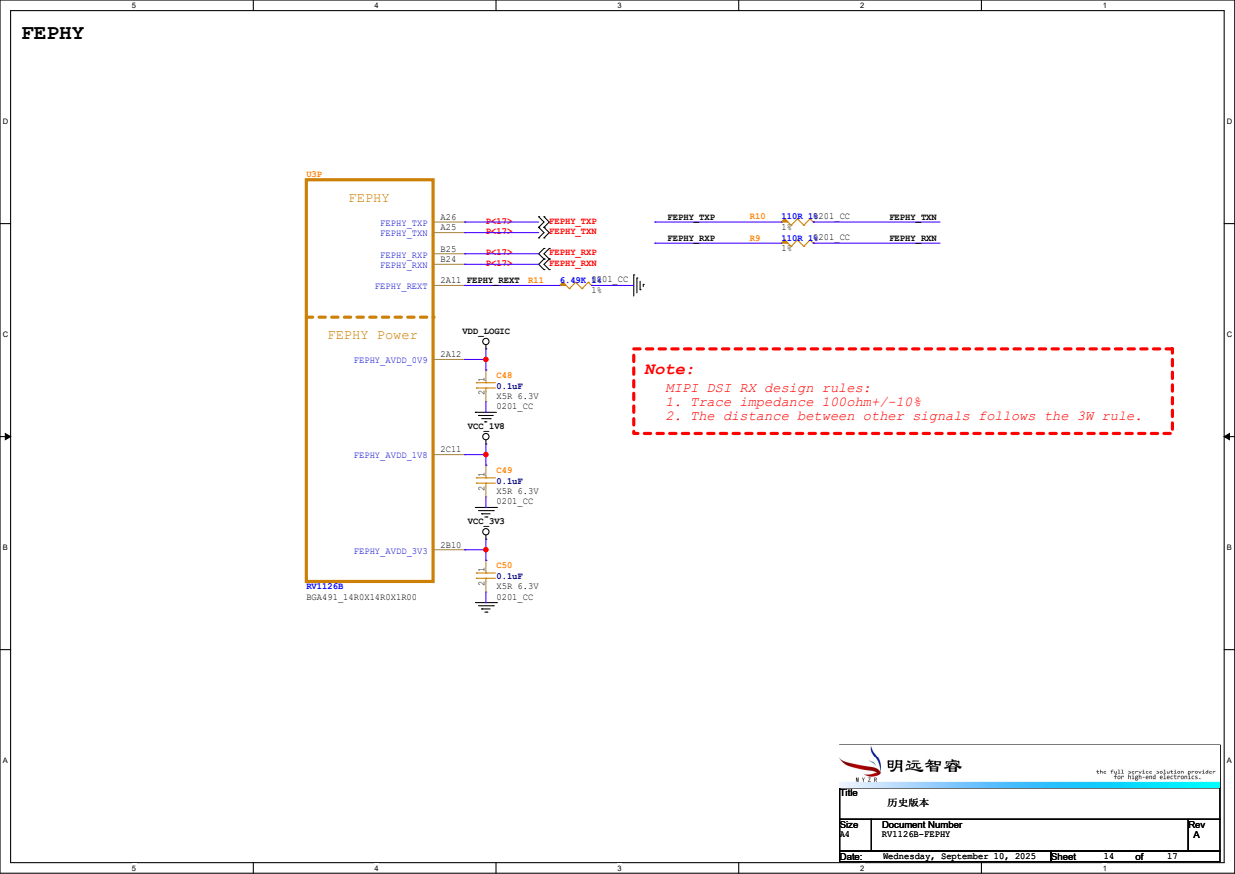
[picture p47: page 9]
VDD_LOGIC; VCC_1V8; VCC_3V3; FEPHY_RXP; FEPHY_RXN; FEPHY_TXN; FEPHY_TXP; Title; RV1126B-FEPHY; Wednesday, September 10, 2025; FEPHY; FEPHY Power; RV1126B BGA491_14R0X14R0X1R00; FEPHY_TXP A26; FEPHY_AVDD_1V8 2C11; FEPHY_AVDD_3V3 2B10; FEPHY_REXT 2A11; FEPHY_RXN B24 FEPHY_RXP B25; FEPHY_TXN A25; FEPHY_AVDD_0V9 2A12; FEPHY_REXT

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

输入到核心板的电源： | 核心板输出的电源：

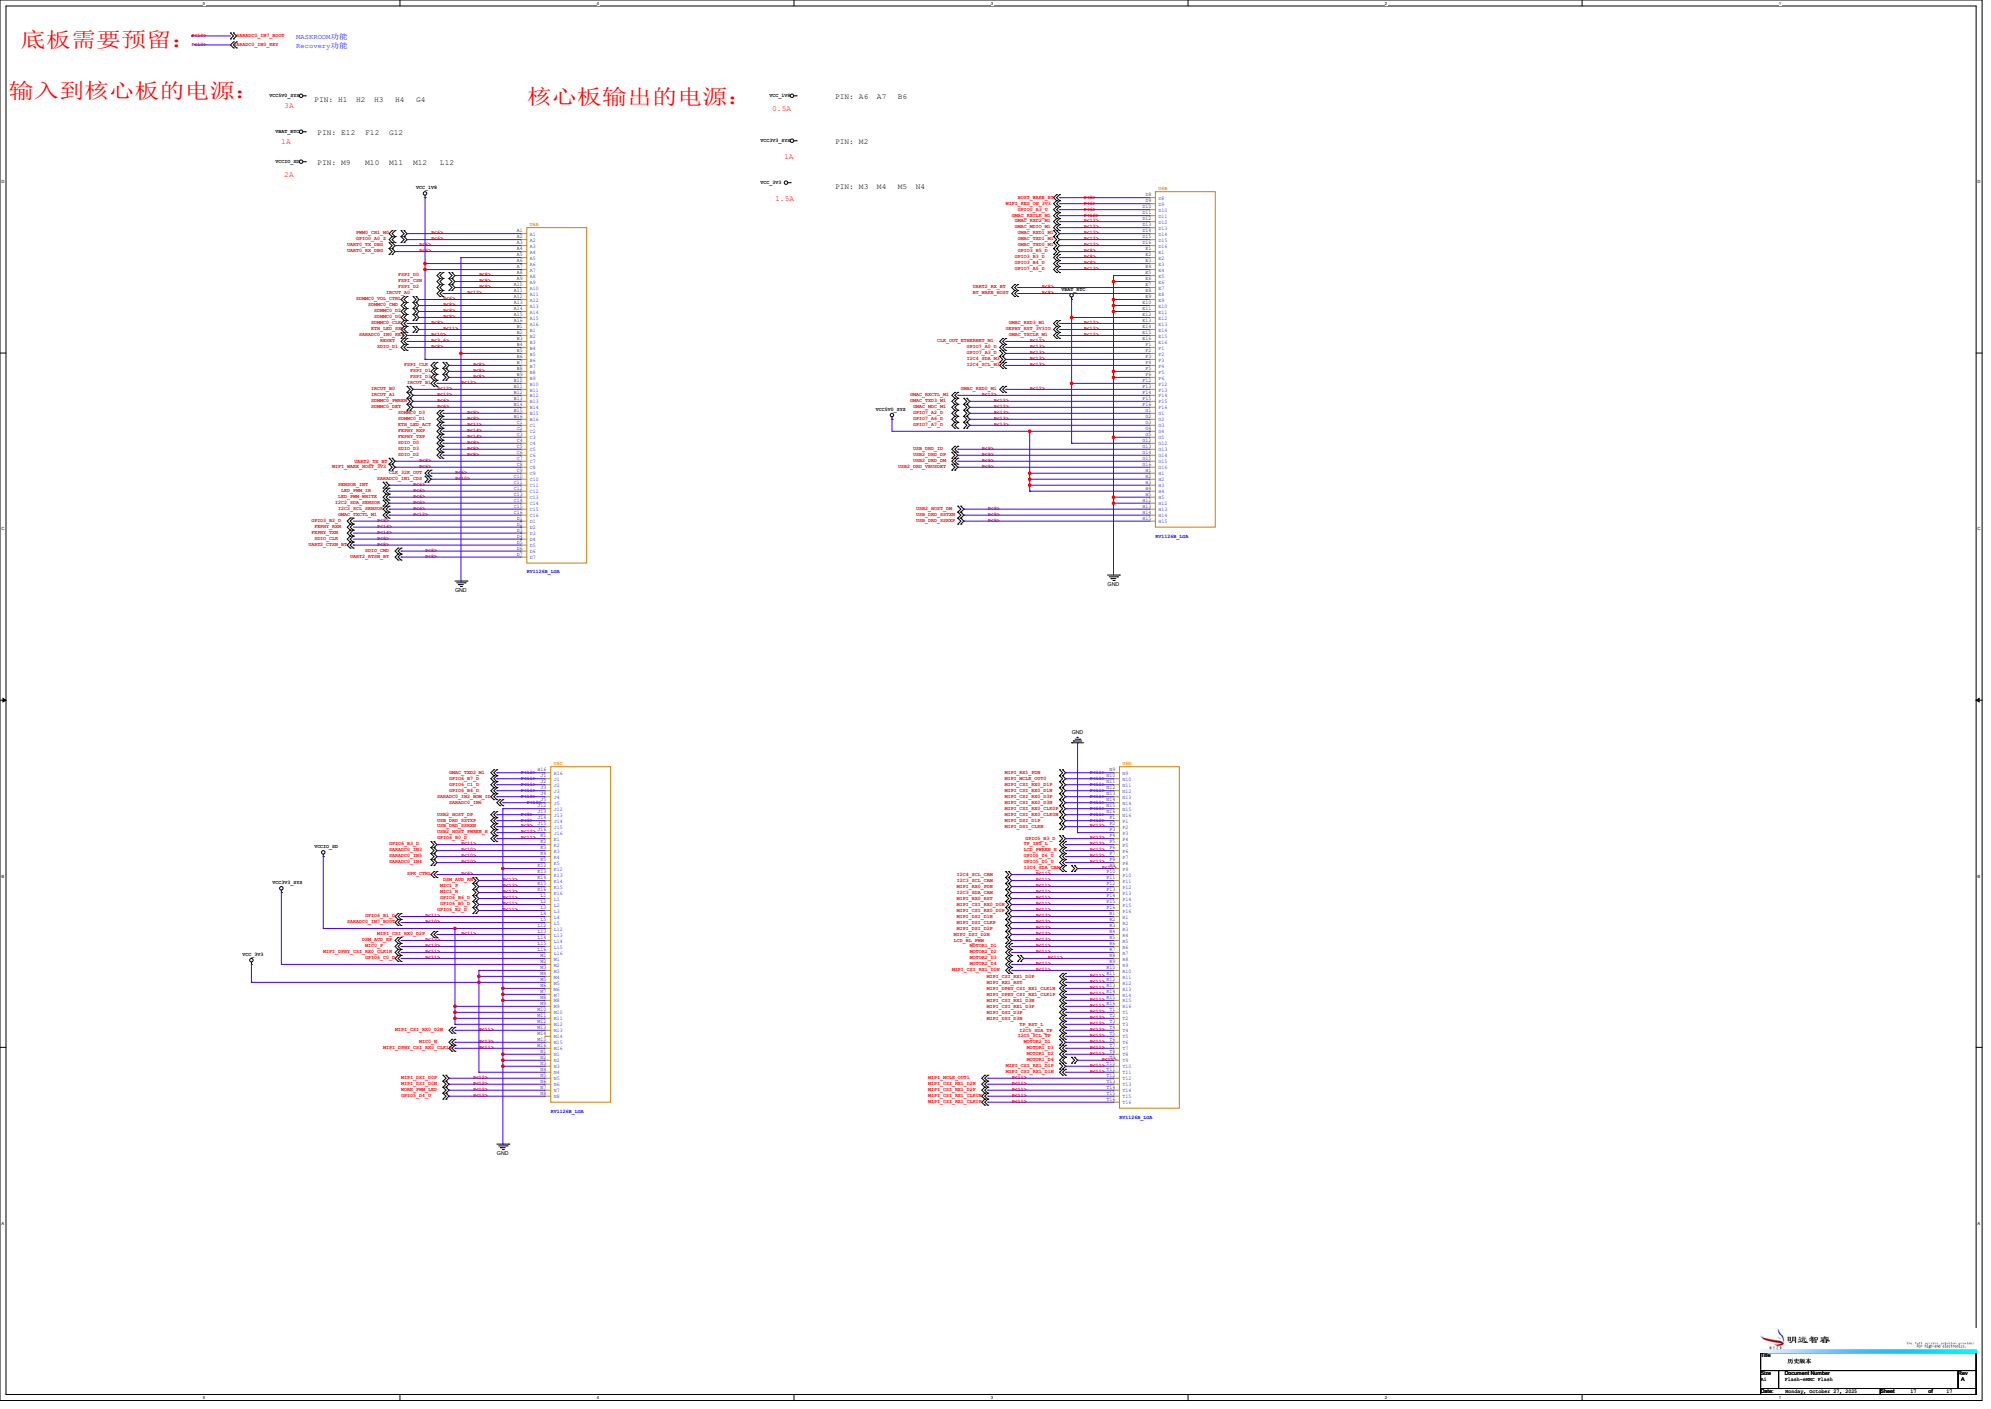
[picture p48: page 10]
