minglang-create/Glove_DAQ_project/STM32/G474CBT6/myDoc/FH64MA-7S-0.25SHW.pdf

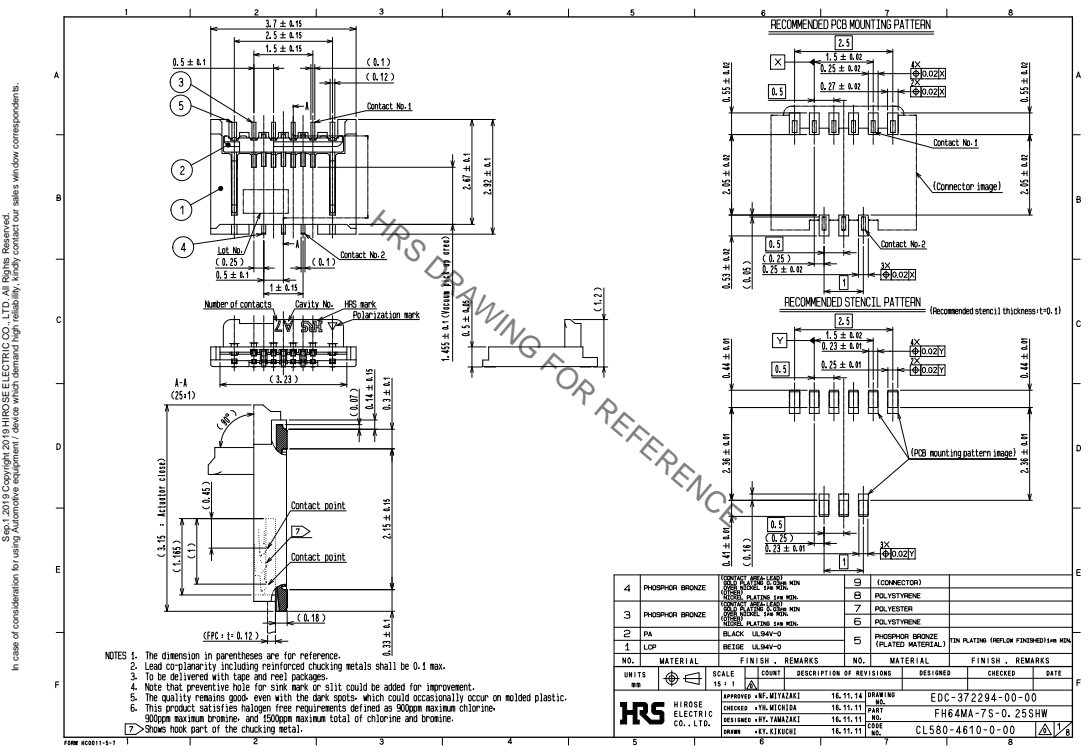
[picture p49: page 1]

HRS DRAWING FOR REFERENCE

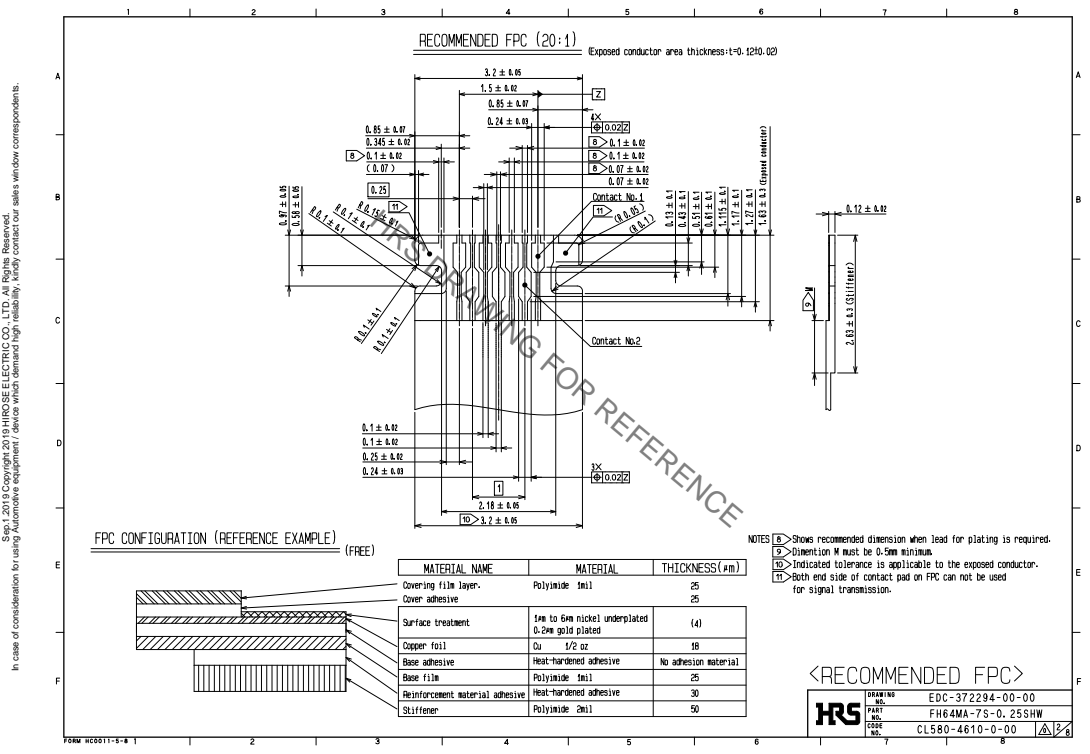
[picture p50: page 2]

HRS DRAWING FOR REFERENCE

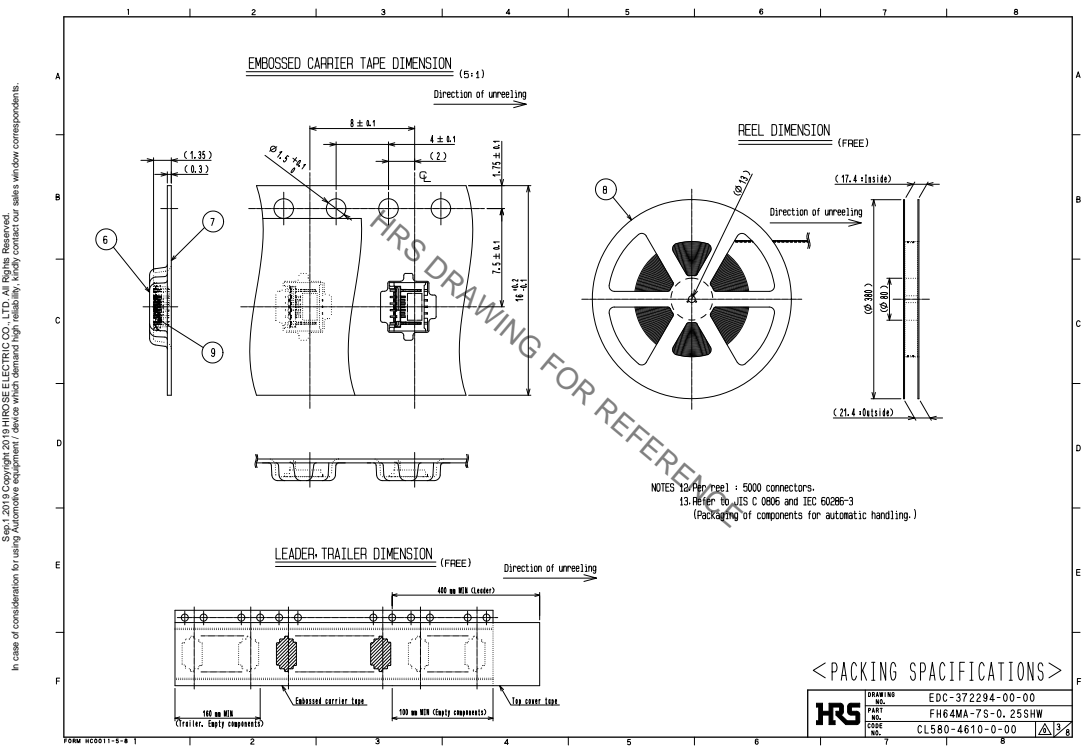
[picture p51: page 3]

HRS DRAWING FOR REFERENCE

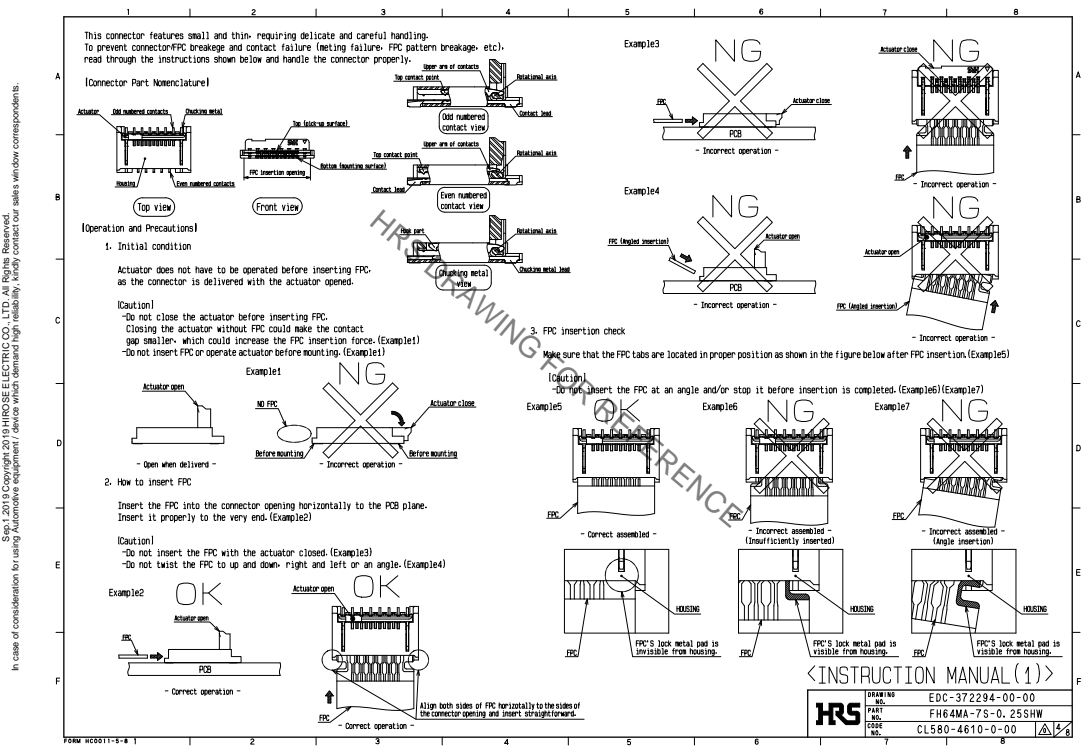
[picture p52: page 4]

HRS DRAWING FOR REFERENCE

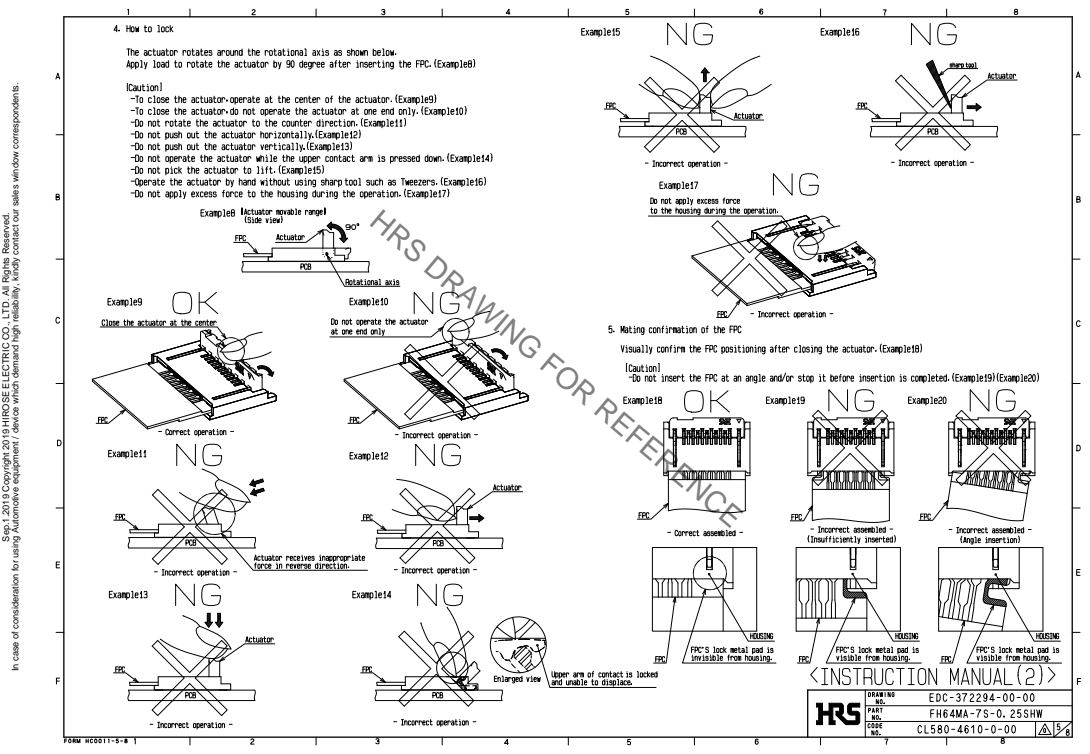
[picture p53: page 5]

HRS DRAWING FOR REFERENCE

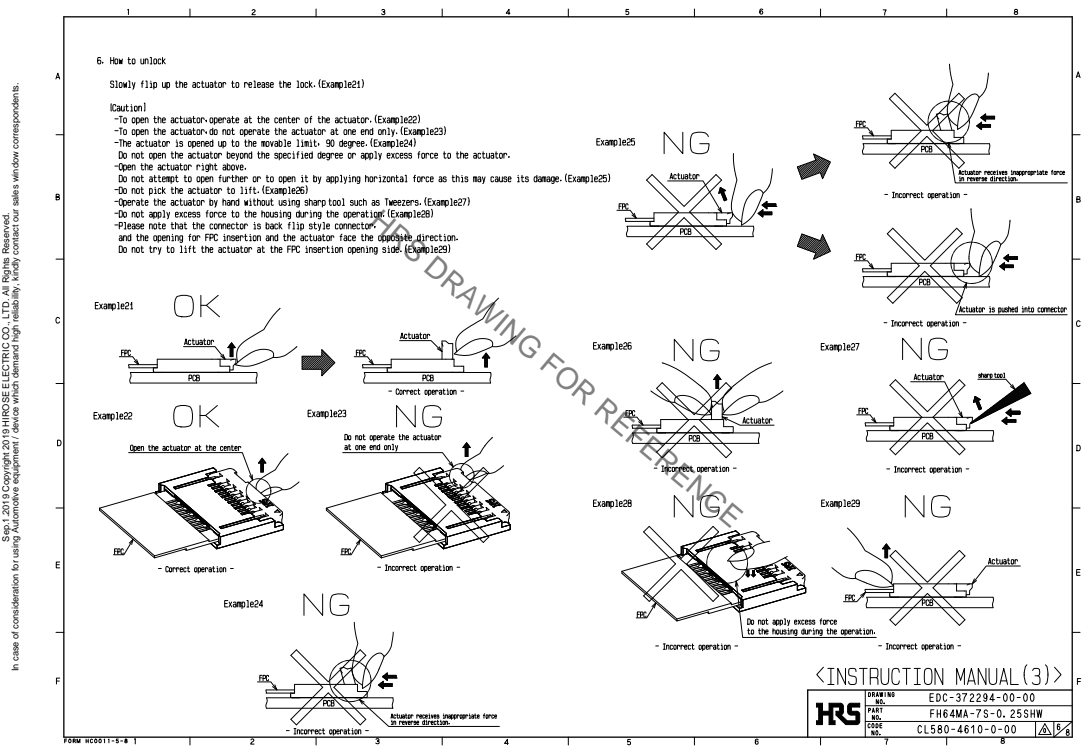
[picture p54: page 6]

HRS DRAWING FOR REFERENCE

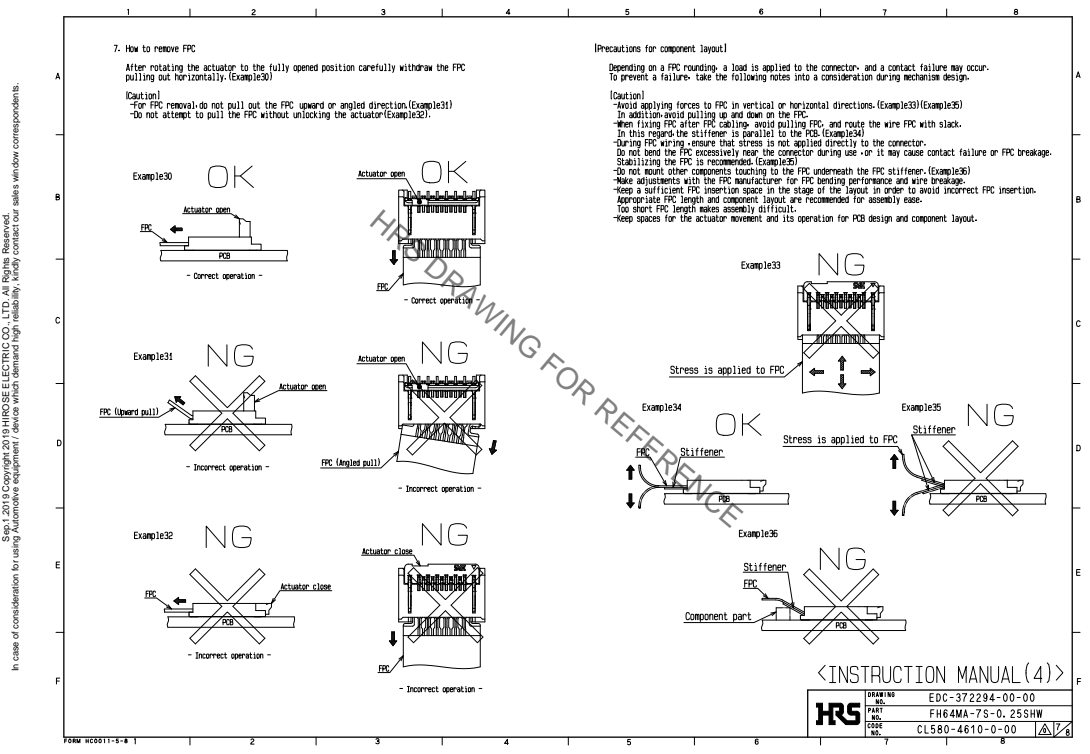
[picture p55: page 7]

HRS DRAWING FOR REFERENCE

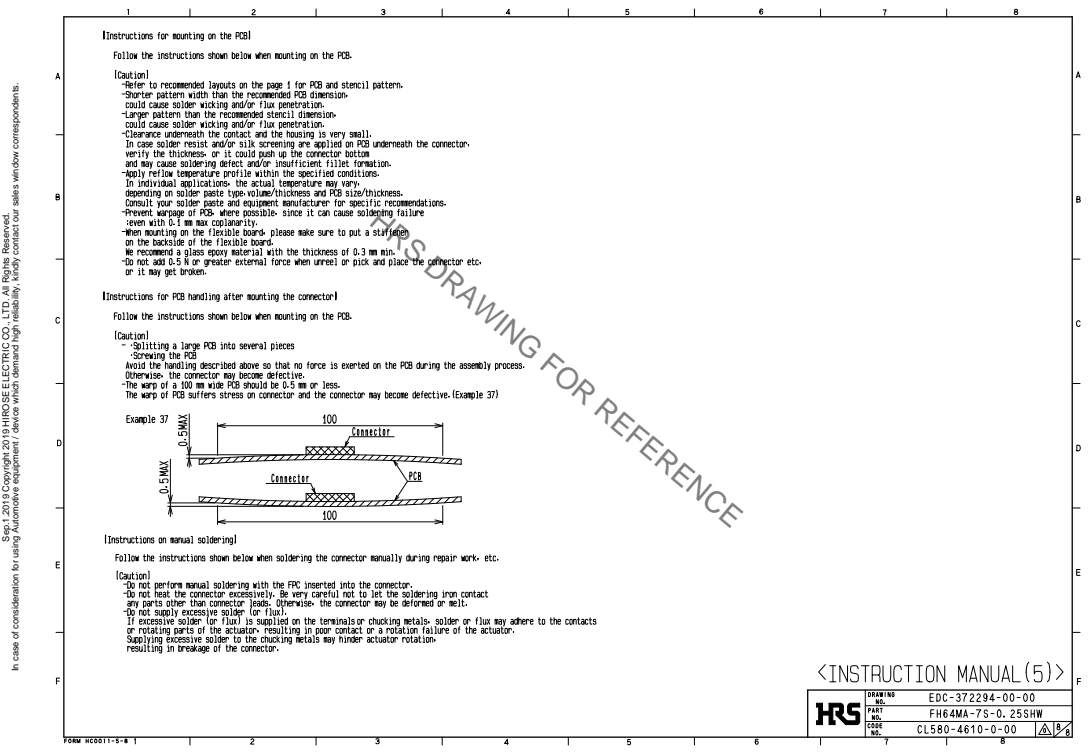
[picture p56: page 8]

HRS DRAWING FOR REFERENCE
