minglang-create/Glove_DAQ_project/STM32/G474CBT6/Core/Src/main.c

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
/* Includes ------------------------------------------------------------------*/
#include "main.h"
#include "adc.h"
#include "crc.h"
#include "dma.h"
#include "fdcan.h"
#include "i2c.h"
#include "spi.h"
#include "tim.h"
#include "gpio.h"

/* USER CODE BEGIN Includes */
#include "glove_app.h"
/* USER CODE END Includes */


/* USER CODE BEGIN PV */
/** Error_Handler 黑匣子：记录调用点的返回地址。跑飞后在 Live Expressions
    看这个值，拿地址到 Debug/G474CBT6.map（或反汇编窗口）里查函数名。 */
volatile uint32_t g_error_handler_lr = 0u;
/* USER CODE END PV */

void SystemClock_Config(void);
/**
  * @brief  The application entry point.
  * @retval int
  */
int main(void)
{

  /* USER CODE BEGIN 1 */
	//第一次烧录进入调试跑一下这一段便可以一直用
	//DBANK=0（单 bank，128KB 连续）：G474CB 出厂 DBANK=1 时 128KB 分两个 64KB
	//bank 且地址不连续（Bank2 在 0x08040000），镜像一超 64KB 就烧不进去。
	//本段代码位于 flash 最前部（两种 bank 模式映射相同），可安全自愈。
	if ((FLASH->OPTR & FLASH_OPTR_nSWBOOT0) || !(FLASH->OPTR & FLASH_OPTR_nBOOT0)
	    || (FLASH->OPTR & FLASH_OPTR_DBANK)) {
	    HAL_FLASH_Unlock(); HAL_FLASH_OB_Unlock();
	    FLASH_OBProgramInitTypeDef ob = {0};
	    ob.OptionType = OPTIONBYTE_USER;
	    ob.USERType   = OB_USER_nSWBOOT0 | OB_USER_nBOOT0 | OB_USER_DBANK;
	    ob.USERConfig = OB_BOOT0_FROM_OB | OB_nBOOT0_SET   /* nSWBOOT0=0, nBOOT0=1 */
	                  | OB_DBANK_128_BITS;                 /* DBANK=0 单 bank      */
	    HAL_FLASHEx_OBProgram(&ob);
	    HAL_FLASH_OB_Launch();   /* 触发重载，芯片复位 */
	}
  /* USER CODE END 1 */

  /* MCU Configuration--------------------------------------------------------*/

  /* Reset of all peripherals, Initializes the Flash interface and the Systick. */
  HAL_Init();

  /* Configure the system clock */
  SystemClock_Config();

  /* Initialize all configured peripherals */
  MX_GPIO_Init();
  MX_DMA_Init();
  MX_FDCAN1_Init();
  MX_FDCAN2_Init();
  MX_FDCAN3_Init();
  MX_SPI1_Init();
  MX_SPI2_Init();
  MX_SPI3_Init();
  MX_ADC1_Init();
  MX_I2C1_Init();
  MX_TIM6_Init();
  MX_CRC_Init();
  MX_TIM2_Init();
  /* USER CODE BEGIN 2 */
  GloveApp_Init();
  /* USER CODE END 2 */

  /* Infinite loop */
  /* USER CODE BEGIN WHILE */
  while (1)
  {
    /* USER CODE END WHILE */

    /* USER CODE BEGIN 3 */
    GloveApp_Loop();
  }
  /* USER CODE END 3 */
}

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
