minglang-create/Glove_DAQ_project/STM32/G474CBT6/G474CBT6.ioc

Mcu.UserName=STM32G474CBTx
PA0.Signal=ADC1_IN1
PA1.Signal=GPIO_Output
PA10.Signal=GPXTI10
PA11.Signal=FDCAN1_RX
PA12.Signal=FDCAN1_TX
PA13.Signal=SYS_JTMS-SWDIO
PA14.Signal=SYS_JTCK-SWCLK
PA15.Signal=FDCAN3_TX
PA3.Signal=GPXTI3
PA4.Signal=SPI1_NSS
PA5.Signal=SPI1_SCK
PA6.Signal=SPI1_MISO
PA7.Signal=SPI1_MOSI
PA8.Signal=FDCAN3_RX
PA9.GPIO_Label=SPI2_CS
PA9.Signal=GPIO_Output
PB10.GPIO_Label=STM32_XVS
PB10.Signal=S_TIM2_CH3
PB11.Signal=GPIO_Input
PB12.Signal=FDCAN2_RX
PB13.Signal=SPI2_SCK
PB14.Signal=SPI2_MISO
PB15.Signal=SPI2_MOSI
PB2.Signal=GPIO_Input
PB3.Signal=SPI3_SCK
PB4.Signal=SPI3_MISO
PB5.Signal=SPI3_MOSI
PB6.Signal=FDCAN2_TX
PB7.GPIO_Label=SPI3_CS
PB7.Signal=GPIO_Output
PB8-BOOT0.Signal=I2C1_SCL
PB9.Signal=I2C1_SDA
PC13.GPIO_Label=IMU_FSYNC
PC13.Signal=GPIO_Output
PF0-OSC_IN.Signal=RCC_OSC_IN
PF1-OSC_OUT.Signal=RCC_OSC_OUT
