minglang-create/Glove_DAQ_project/STM32/G474CBT6/Core/Inc/main.h

#define IMU_FSYNC_Pin GPIO_PIN_13
#define IMU_FSYNC_GPIO_Port GPIOC
#define STM32_XVS_Pin GPIO_PIN_10
#define STM32_XVS_GPIO_Port GPIOB
#define SPI2_CS_Pin GPIO_PIN_9
#define SPI2_CS_GPIO_Port GPIOA
#define SPI3_CS_Pin GPIO_PIN_7
#define SPI3_CS_GPIO_Port GPIOB
