minglang-create/Glove_DAQ_project/RV1126B/daq_fsm.h

/* =============================================================================
 * daq_fsm.h —— 手套 DAQ 生命周期状态机(按《协议契约_V1 第四次修订》实现)
 *
 *   SELFCHECK → WAIT_READY(自检包/按键/0xC301) → CAM_START → WAIT_FRAME
 *   → RUNNING ⇄ PAUSED → SHUTDOWN
 *
 * 事件来源: ① SPI 小包(100ms 轮询) ② 数据帧出现(采集开始的最终确认)
 *          ③ 按键(短按=开始/暂停/恢复, 长按=结束) ④ 信号(USR2=模拟短按,
 *          USR1=发 0x5F01 重新自检并重启进程, INT/TERM=优雅退出)
 * ============================================================================= */
#ifndef DAQ_FSM_H
#define DAQ_FSM_H
#include "cam_pipeline.h"

typedef struct {
	int auto_mode;         /* -A 台架直通: 不等按键/0xC301, MISO 见数据帧即启相机开跑 */
	int no_cam;            /* -X 纯链路调试: 不碰相机 */
	int verify_fake;       /* -V 假数据逐帧验收 */
	const char *rec_dir;   /* 落盘基目录(NULL=不落盘) */
	cam_cfg_t   cam;
} fsm_cfg_t;

/* 阻塞运行到结束。返回 0=正常退出, 2=已发 0x5F01 请求重新自检(调用方应 exec 重启自身) */
int  fsm_run(const fsm_cfg_t *cfg);

void fsm_request_button(int long_press);   /* 供按键线程/信号处理调用 */
void fsm_request_recheck(void);            /* SIGUSR1 */
void fsm_request_quit(void);               /* SIGINT/SIGTERM */
void fsm_bind_cam(void);                   /* 把对齐+落盘挂到相机帧对回调 */
#endif
