minglang-create/Glove_DAQ_project/(commit log)

2026-09-04 初始提交: Glove_DAQ RV1126B 侧采集系统
    RV1126B(下位机)完整实现: 双 IMX415 硬同步采集 + STM32G474 手套链路
    + 帧↔CYCLE 自动对齐 + 分段落盘。
    模块:
    - daq_fsm 生命周期状态机(自检→主从分配→启相机→运行⇄暂停)
    - glove_link SPI 事务层(恒定 2690B 全双工/小包/数据帧/CRC-16 ARC/PA1 握手)
    - cam_pipeline 双摄采集管线(ISP→VI→VENC H.265→时间戳配对)
    - align 相机帧↔周期号自动标定(PA1 沿内核时间戳锚定 + 中位数 offset)
    - recorder 分段落盘(码流 + pairs.csv + glove.bin/csv, 按 CYCLE 联结)
    - glove_view 终端可视化; button 按键; S89insmod_ko.sh 开机加载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
2026-09-04 重组仓库为双子系统结构: RV1126B/ + STM32/
    - 原有下位机全部内容移入 RV1126B/(内核快照的 SDK 镜像路径完整保留)
    - 新建 STM32/ 目录并放说明(职责分工、协议契约指引、关键约定摘要), 待推送固件
    - 顶层 README 重写为系统全貌: 双芯片分工、XVS 时基思想、阅读路径、硬件版本状态
    - 修 board_kernel_mods 脚本两处: 相对路径深度随目录调整; cd 移到路径检查之前
    (原逻辑相对路径会随调用者 CWD 漂移, 换目录调用即失效)
2026-09-04 修 Makefile 相对路径(目录深一层)+ 补 RV1126B/README
    - Makefile: ../Makefile.param → ../../, cam_daq/common.mk 同理; 编译已验证通过
    - 新增 RV1126B/README.md: 上手步骤/参数表/目录结构/内核依赖/引脚表,
    并把"从机启动必须 XVS+XHS"这条实测硬约束与证据写在显眼处
2026-09-04 STM32 固件快照：握手/帧数一致方案（相机从同步版，即将改为 CAM0 主模式出 XVS）
    - 碳膜 ADC2CAN 模式（GLOVE_SENSOR_MODE=2）+ MCP 宏隔离
    - 单按键握手：宣告/握手窗口/0xC301 开采请求/0xC101 回执
    - LED 三态（PB2）、CYCLE 同源、DBANK/BOOT0 自愈
    - myDoc：协议契约 V1（第四次修订）、架构交接、致 RV 说明
2026-09-04 简化启动方案: XVS 源移回 cam0(主机相机), STM32 改捕获
    背景: 实验B实锤 IMX415 从机启动必须 XVS+XHS 双信号, 而 V4 板 XHS 网未接
    STM32 → "STM32 供 XVS 驱动双从"走不通。
    方案(docs/STARTUP_SIMPLE.md):
    - dts 切回 hwsync(cam0=internal_master 自产 XVS+XHS / cam1=slave),
    V2/V3 已验证 dpts 恒 -6µs; STM32 PB10 从定时器输出改为输入捕获(TXS 自动转向)
    - 启动链: 按键→0x5101→STM32 拉低 XVS 50ms 宣告→切输入捕获→0xC301→
    RV 启相机(cam0 起振即发 XVS)→STM32 捕获计 CYCLE→数据帧→RUNNING
    - 主从简化: 主机不等从机、无应答窗, 工人看灯判断; 双手场景待下版板(见文档边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
