minglang-create/Glove_DAQ_project/(notices)

Notices in the files:
STM32/G474CBT6/Core/Inc/main.h:
Copyright (c) 2026 STMicroelectronics.
All rights reserved.
This software is licensed under terms that can be found in the LICENSE file
